MaxRink/km271-wifi/docs/pr-images/jlcpcb-ready/ETH_W5500_pcb_back_after.png

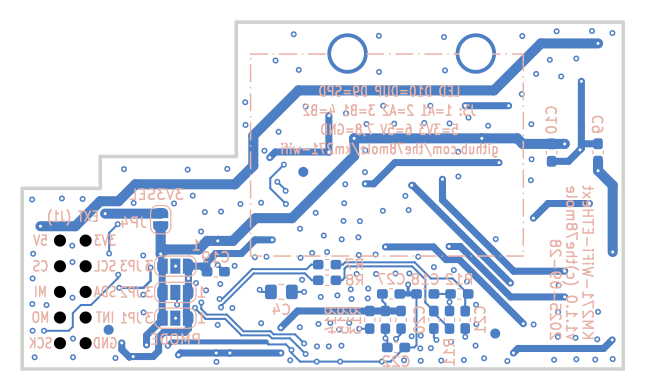
docs/pr-images/jlcpcb-ready/ETH_W5500_pcb_back_after.png
