MaxRink/km271-wifi/docs/pr-images/jlcpcb-ready/ETH_W5500_pcb_back_crop2.png

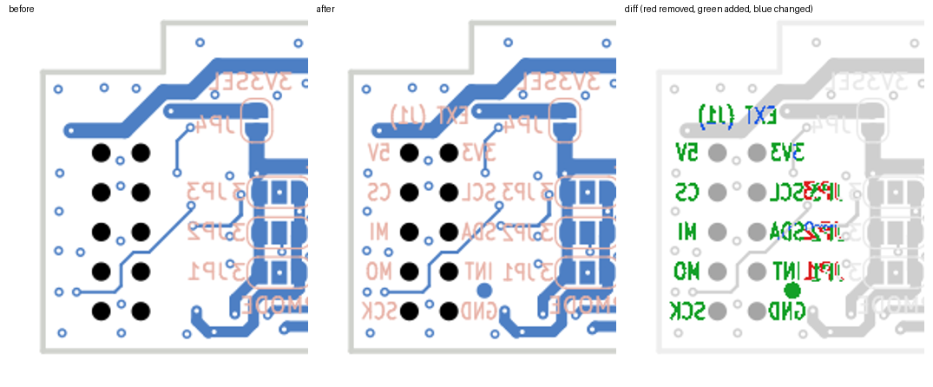
docs/pr-images/jlcpcb-ready/ETH_W5500_pcb_back_crop2.png
