MaxRink/km271-wifi/docs/pr-images/jlcpcb-ready/ETH_W5500_pcb_front_crop1.png

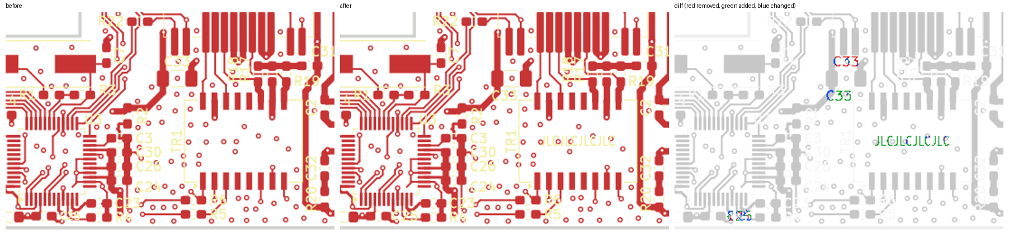
docs/pr-images/jlcpcb-ready/ETH_W5500_pcb_front_crop1.png
