MaxRink/km271-wifi/docs/pr-images/jlcpcb-ready/ETH_W5500_render_iso_after.png

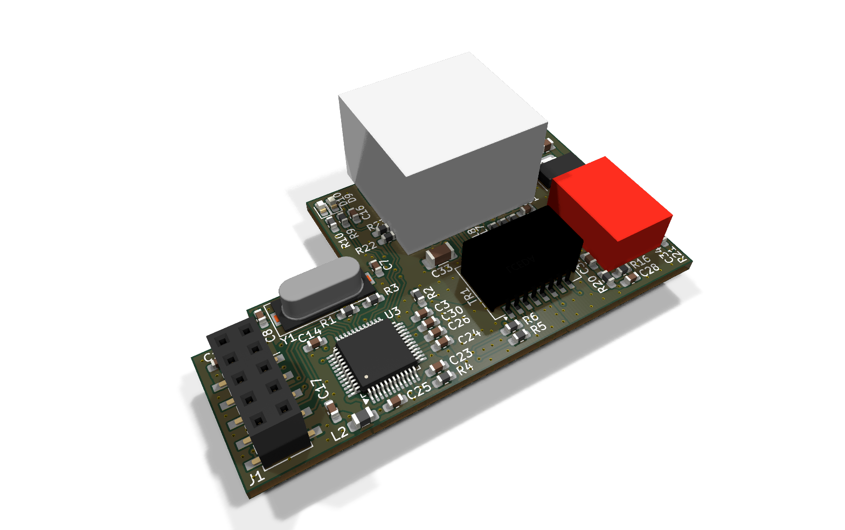
docs/pr-images/jlcpcb-ready/ETH_W5500_render_iso_after.png
