MaxRink/km271-wifi/docs/pr-images/jlcpcb-ready/ETH_W5500_render_top_before.png

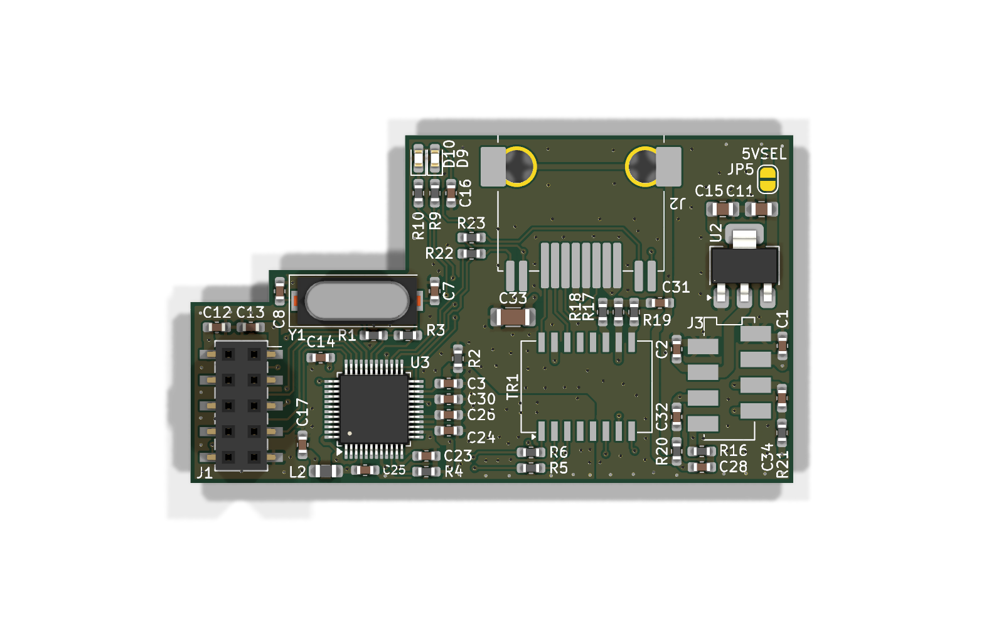
docs/pr-images/jlcpcb-ready/ETH_W5500_render_top_before.png
