MaxRink/km271-wifi/docs/pr-images/jlcpcb-ready/ETH_W5500_sch_crop7.png

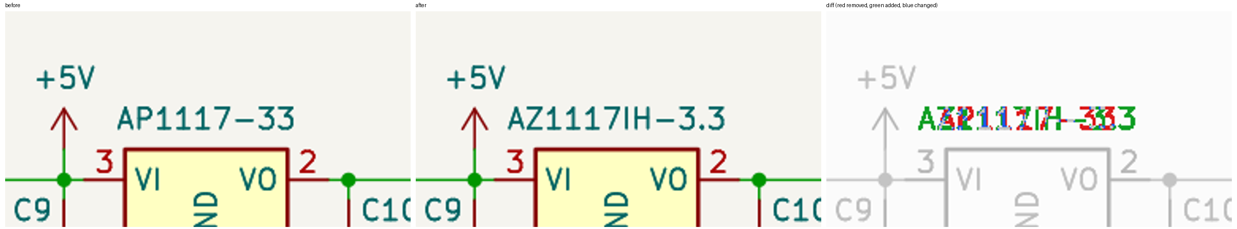
docs/pr-images/jlcpcb-ready/ETH_W5500_sch_crop7.png
