MaxRink/km271-wifi/docs/pr-images/jlcpcb-ready/ETH_W5500_sch_diff.png

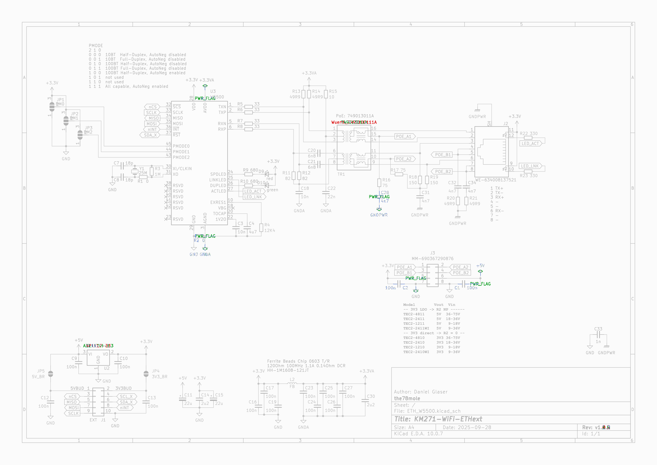
docs/pr-images/jlcpcb-ready/ETH_W5500_sch_diff.png
