MaxRink/km271-wifi/docs/pr-images/jlcpcb-ready/KM217-WiFi_pcb_back_after.png

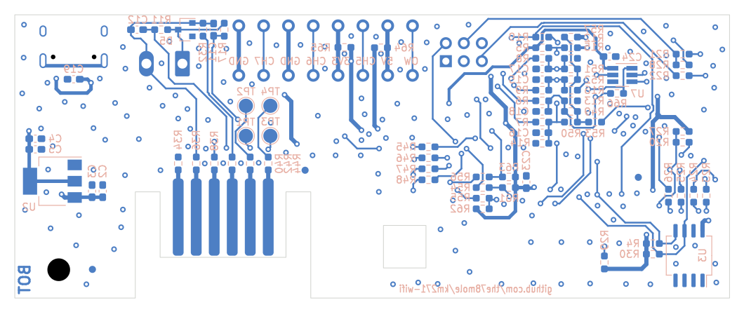
docs/pr-images/jlcpcb-ready/KM217-WiFi_pcb_back_after.png
