MaxRink/km271-wifi/docs/pr-images/jlcpcb-ready/KM217-WiFi_pcb_back_crop1.png

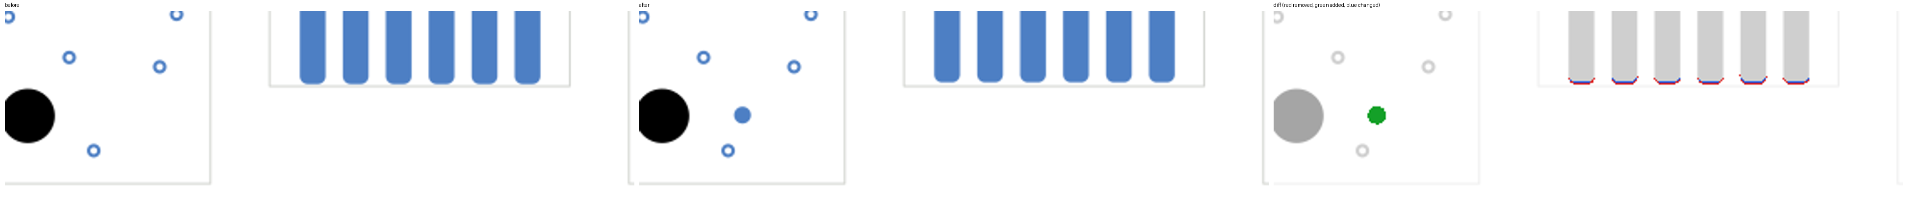
docs/pr-images/jlcpcb-ready/KM217-WiFi_pcb_back_crop1.png
