MaxRink/km271-wifi/docs/pr-images/jlcpcb-ready/KM217-WiFi_pcb_front_before.png

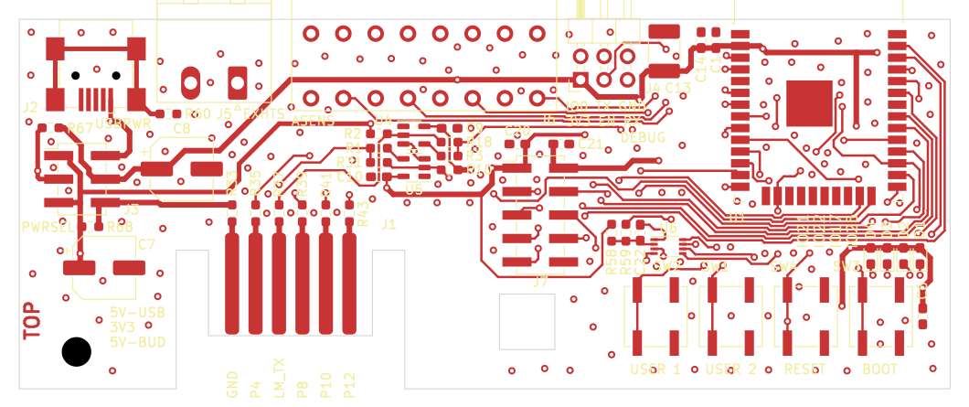
docs/pr-images/jlcpcb-ready/KM217-WiFi_pcb_front_before.png
