MaxRink/km271-wifi/docs/pr-images/jlcpcb-ready/KM217-WiFi_render_bottom_before.png

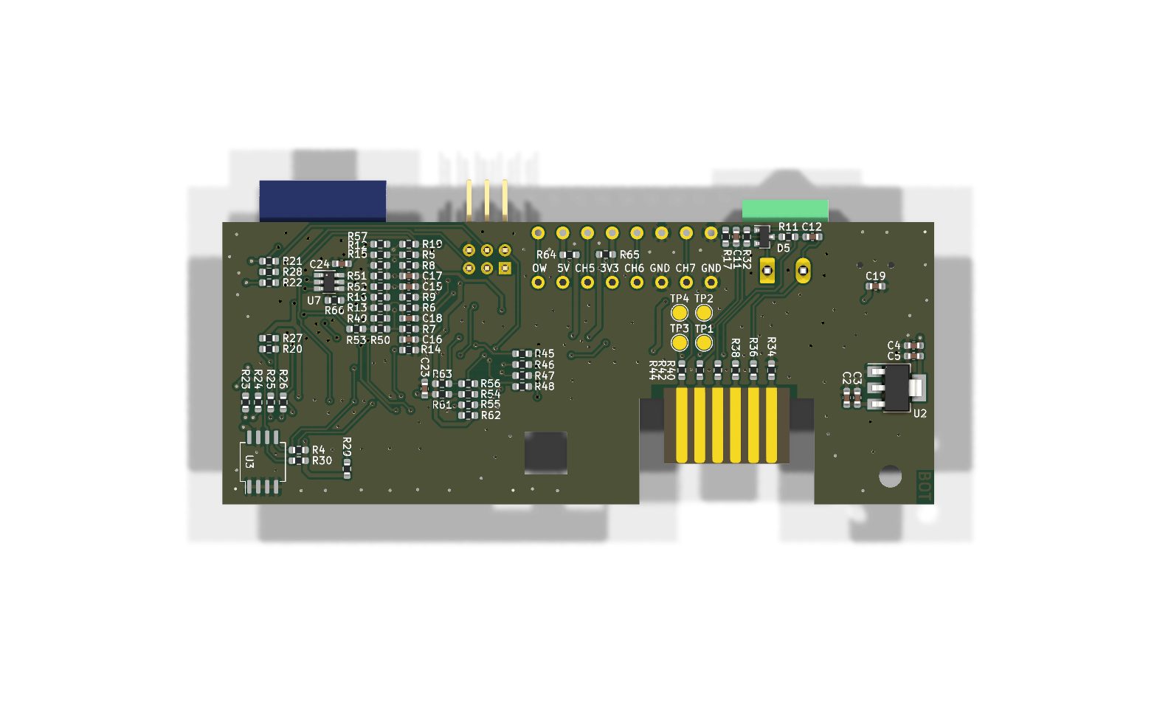
docs/pr-images/jlcpcb-ready/KM217-WiFi_render_bottom_before.png
