MaxRink/km271-wifi/docs/pr-images/jlcpcb-ready/KM217-WiFi_render_top_after.png

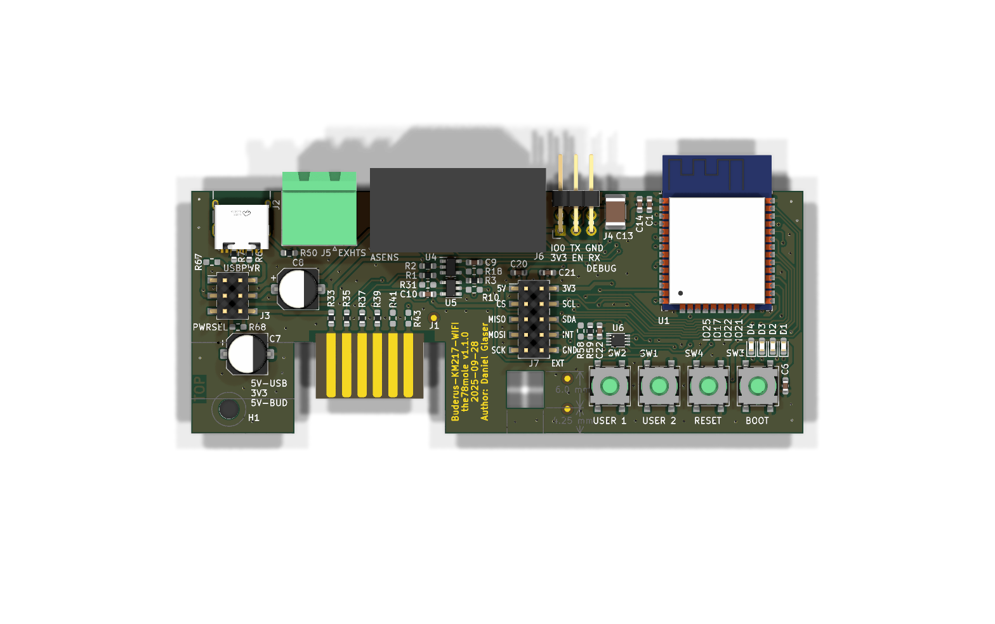
docs/pr-images/jlcpcb-ready/KM217-WiFi_render_top_after.png
