MaxRink/km271-wifi/docs/pr-images/jlcpcb-ready/KM217-WiFi_sch_crop2.png

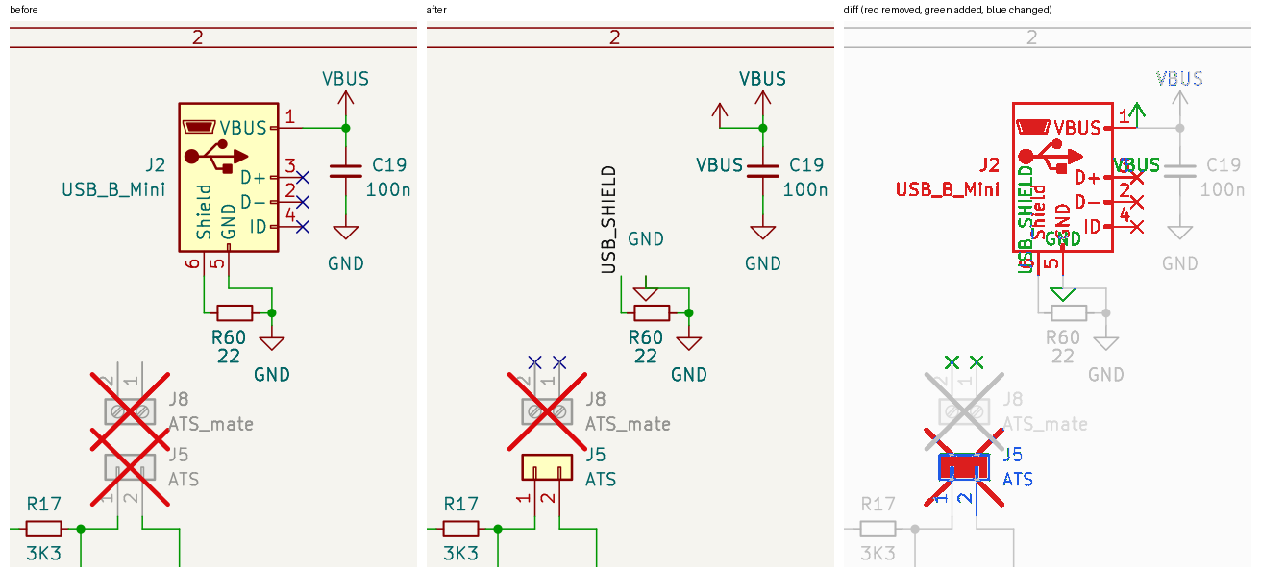
docs/pr-images/jlcpcb-ready/KM217-WiFi_sch_crop2.png
