MaxRink/km271-wifi/IMG/jlc/KM217-WiFi_v1.0.2_top.png

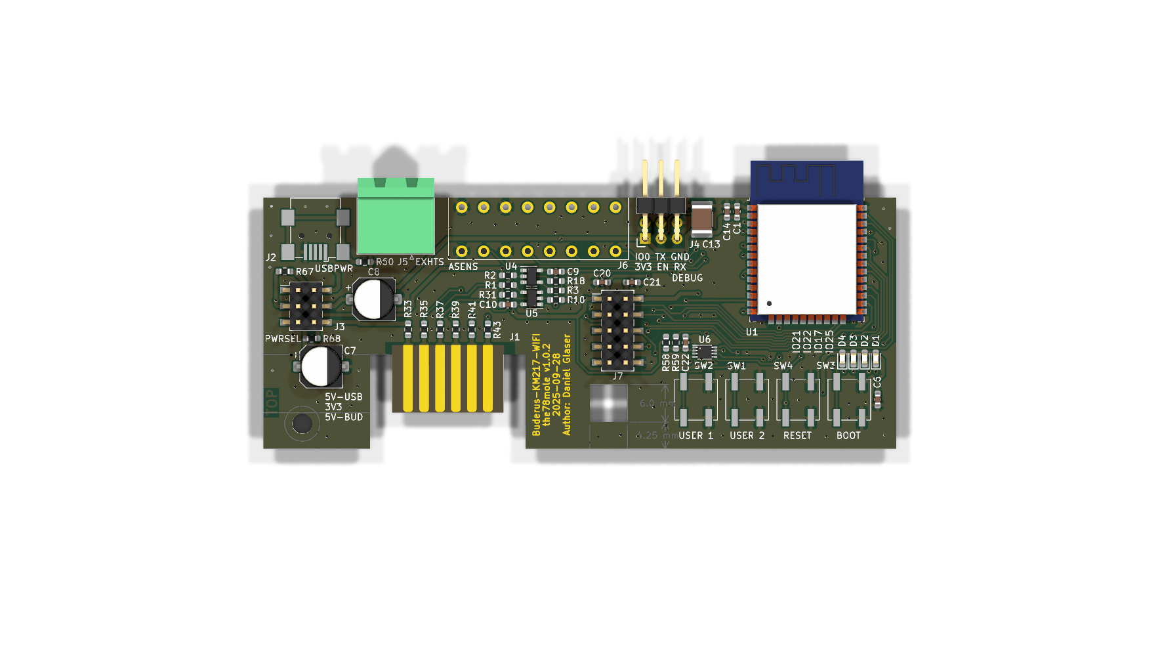
IMG/jlc/KM217-WiFi_v1.0.2_top.png
