MaxRink/km271-wifi/KM217-WiFi/production/bom.csv

Designator | Footprint | Quantity | Value | LCSC Part #
C1, C10, C11, C15, C16, C17, C19, C20, C21, C22, C23, C24, C3, C4, C6, C9 | 0603 | 16 | 100n | C14663
C12 | 0603 | 1 | 33n | C21117
C13 | 1812 | 1 | 22u/25V | C76690
C14, C2, C5 | 0603 | 3 | 2u2 | C23630
C18 | 0603 | 1 | 4p7 | C1669
C7, C8 | CP_Elec_6.3x5.4_Nichicon | 2 | 100u/16V | C340722
D1, D2 | 0603 | 2 | LED green | C12624
D3 | 0603 | 1 | LED yellow | C2287
D4 | 0603 | 1 | LED red | C2286
J2 | USB_C_Receptacle_HRO_TYPE-C-31-M-12 | 1 | USB_C | C165948
J3 | PinHeader_2x03_P2.54mm_Vertical_SMD | 1 | VSEL | C32713283
J4 | PinHeader_2x03_P2.54mm_Horizontal | 1 | DEBUG | C41417351
J5 | PhoenixContact_MSTBA_2,5_2-G-5,08_1x02_P5.08mm_Horizontal | 1 | ATS | C90074
J6 | WAGO 2086-1208 | 1 | TSENS | C6074290
J7 | PinHeader_2x05_P2.54mm_Vertical_SMD | 1 | EXT | C3330868
R1, R19, R20, R21, R22, R3 | 0603 | 6 | 220 | C22962
R11, R5 | 0603 | 2 | 100K | C25803
R12 | 0603 | 1 | 47K | C25819
R16, R49, R50, R51 | 0603 | 4 | 1K | C21190
R17 | 0603 | 1 | 3K3 | C22978
R2, R27, R29, R32 | 0603 | 4 | 10K | C25804
R23, R24, R25, R26 | 0603 | 4 | 680 | C23228
R28 | 0603 | 1 | 1M | C22935
R30, R4, R61, R62, R63 | 0603 | 5 | 4K7 | C23162
R33, R34, R35, R36, R37, R38, R39, R40, R57, R59, R64, R65, R66, R7, R8 | 0603 | 15 | 0 | C21189
R45, R46, R47, R48, R54, R55, R56, R60 | 0603 | 8 | 22 | C23345
R6 | 0603 | 1 | 10 | C22859
R69, R70 | 0603 | 2 | 5K1 | C23186
R9 | 0603 | 1 | 330 | C23138
SW1 | SW_SPST_B3SL-1002P | 1 | USER2 | C306880
SW2 | SW_SPST_B3SL-1002P | 1 | USER1 | C306880
SW3 | SW_SPST_B3SL-1002P | 1 | BOOT | C306880
SW4 | SW_SPST_B3SL-1002P | 1 | RESET | C306880
U1 | ESP32-WROOM-32 | 1 | ESP32-WROOM-32E-N8 | C701342
U2 | SOT-223-3_TabPin2 | 1 | AZ1117IH-3.3TRG1 | C108495
U4, U5 | SOT-23-5 | 2 | SN74LV1T34DBV | C100024
U6 | VSSOP-8_2.3x2mm_P0.5mm | 1 | PCA9306DC1 | C5119911
