MaxRink/km271-wifi/EXTENSIONS/ETH_W5500/production/bom.csv

Designator | Footprint | Quantity | Value | LCSC Part #
C1, C10, C12, C13, C16, C17, C19, C2, C23, C24, C25, C26, C27, C9 | 0603 | 14 | 100n | C14663
C11, C15 | 0805 | 2 | 22u | C45783
C14, C30 | 0603 | 2 | 2u2 | C23630
C18, C3 | 0603 | 2 | 10n | C57112
C20, C21 | 0603 | 2 | 6n8 | C1631
C22 | 0603 | 1 | 22n | C21122
C28, C31, C32, C34 | 0603 | 4 | 4n7 | C53987
C33 | 1206 | 1 | 1n | C9196
C4 | 0805 | 1 | 4u7 | C1779
C7, C8 | 0603 | 2 | 18p | C1647
D10 | 0603 | 1 | green | C12624
D9 | 0603 | 1 | red | C2286
J1 | WE_PinSocket_TH_2x05_P2.54mm_Vertical_SMD | 1 | EXT | C843271
J2 | WE-MJ-634008137521 | 1 | WE-634008137521 | C6095310
J3 | WE-MM-690367290876 | 1 | MM-690367290876 | C20476862
L2 | 0805 | 1 | FB | C1015
R1, R2 | 0603 | 2 | 0 | C21189
R10, R9 | 0603 | 2 | 680 | C23228
R11, R12 | 0603 | 2 | 82 | C23255
R13, R14, R20, R21 | 0603 | 4 | 49R9 | C23185
R15 | 0603 | 1 | 10 | C22859
R16, R17 | 0603 | 2 | 75 | C4275
R18, R19 | 0603 | 2 | 150 | C22808
R22, R23 | 0603 | 2 | 330 | C23138
R3 | 0603 | 1 | 1M | C22935
R4 | 0603 | 1 | 12K4 | C177422
R5, R6, R7, R8 | 0603 | 4 | 33 | C23140
TR1 | Transformer_Ethernet_Wuerth_749013011A | 1 | 749013011A | C7193798
U2 | SOT-223-3_TabPin2 | 1 | AZ1117IH-3.3 | C108495
U3 | LQFP-48_7x7mm_P0.5mm | 1 | W5500 | C32843
Y1 | Crystal_SMD_HC49-SD | 1 | 25M | C596824
