MaxRink/km271-wifi/3dmodels/Wuerth_749013011A.step

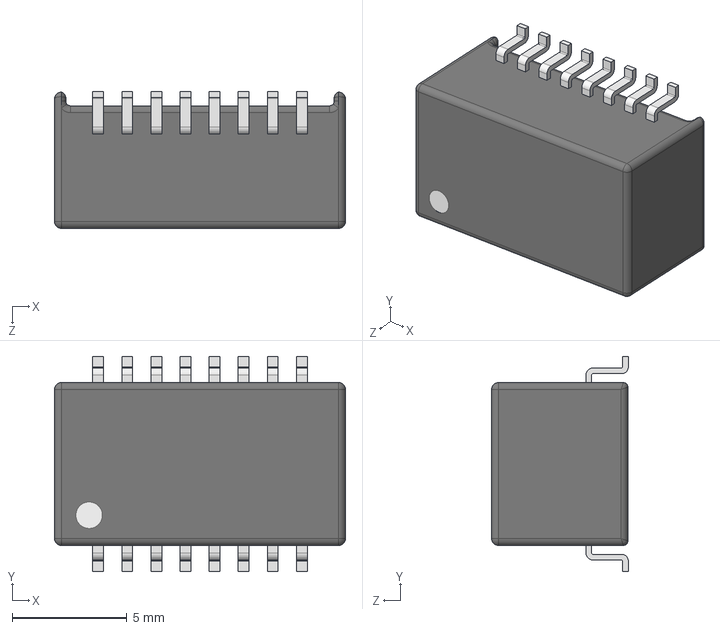
[picture p52: CAD file, 2026-10-25]
3dmodels/Wuerth_749013011A.step
12.7 x 9.40 x 5.97 mm
