MaxRink/km271-wifi/EXTENSIONS/ETH_W5500/production/ETH_W5500.step

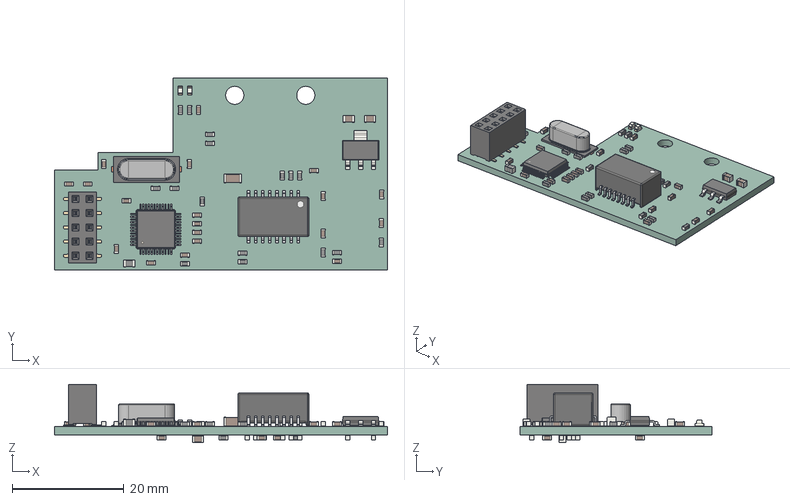
[picture p53: CAD file, 2026-10-25]
EXTENSIONS/ETH_W5500/production/ETH_W5500.step
59.5 x 34.3 x 10.4 mm
C_0603_1608Metric x 27
SOT-223
PinSocket_2x05_P2.54mm_Vertical_SMD
C_1206_3216Metric
L_0603_1608Metric x 23
XFMR-SMD_16P-L12.7-W7.1-P1.27-LS9.4-BL
LED_0603_1608Metric x 2
Crystal_SMD_HC49-SD
L_0805_2012Metric
C_0805_2012Metric x 3
LQFP-48_7x7mm_P0.5mm
.step_tmp_ETH_W5500_PCB
