MaxRink/km271-wifi/KM217-WiFi/production/KM217-WiFi.step

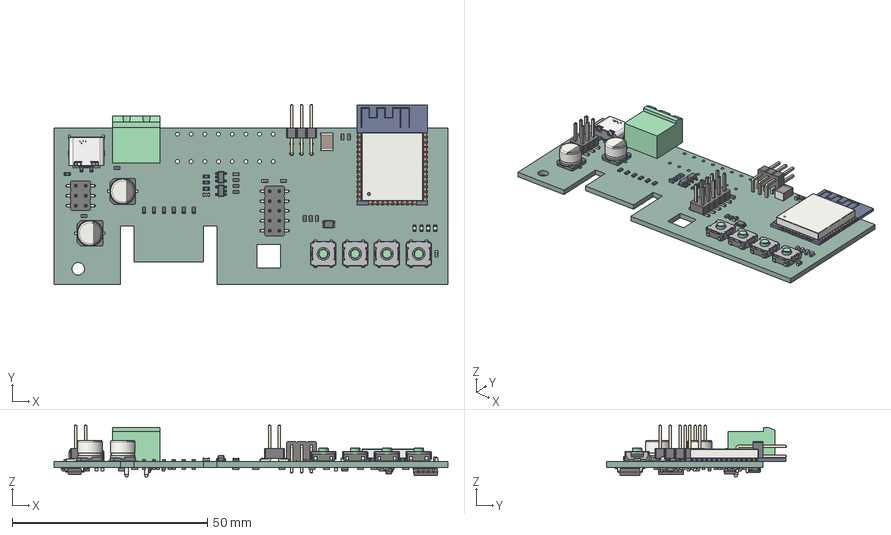
[picture p54: CAD file, 2026-10-25]
KM217-WiFi/production/KM217-WiFi.step
100.8 x 46.0 x 13.3 mm
SW_SPST_B3SL-1002P x 4
R_0603_1608Metric x 70
LED_0603_1608Metric x 4
C_0603_1608Metric x 21
VSSOP-8_2.3x2mm_P0.5mm
SOT-23-5 x 2
PinHeader_2x05_P254mm_Vertical_SMD
CP_Elec_63x54_Nichicon x 2
PinHeader_2x03_P254mm_Horizontal
C_1812_4532Metric
PinHeader_2x03_P254mm_Vertical_SMD
USB-C_SMD-TYPE-C-31-M-12
MSTBA_01x02_G_5_08mm
ESP32-WROOM-32
SOIC-8_5.3x6.2mm_P1.27mm
SOT-23-6
SOT-223
D_SOT_23
.step_tmp_KM217-WiFi_PCB
