MaxRink/km271-wifi/3dmodels/USB-C_HRO_TYPE-C-31-M-12.step

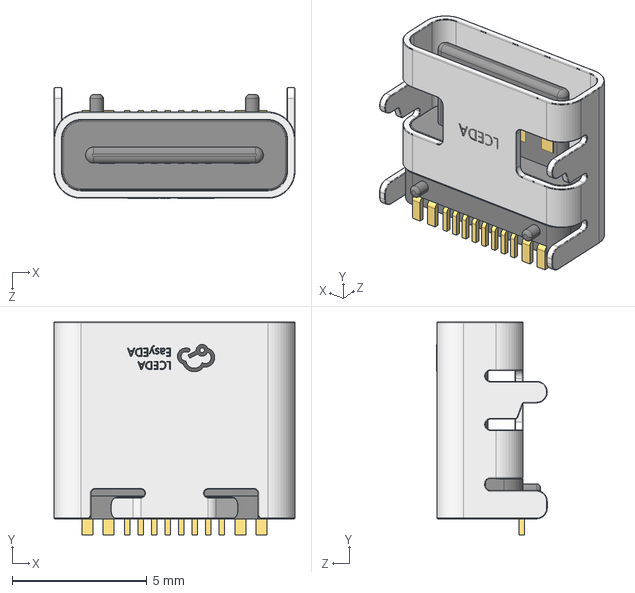
[picture p55: CAD file, 2026-10-25]
3dmodels/USB-C_HRO_TYPE-C-31-M-12.step
8.94 x 7.90 x 4.10 mm
