MaxRink/km271-wifi/KM217-WiFi/production/KM217-WiFi_schematic.pdf

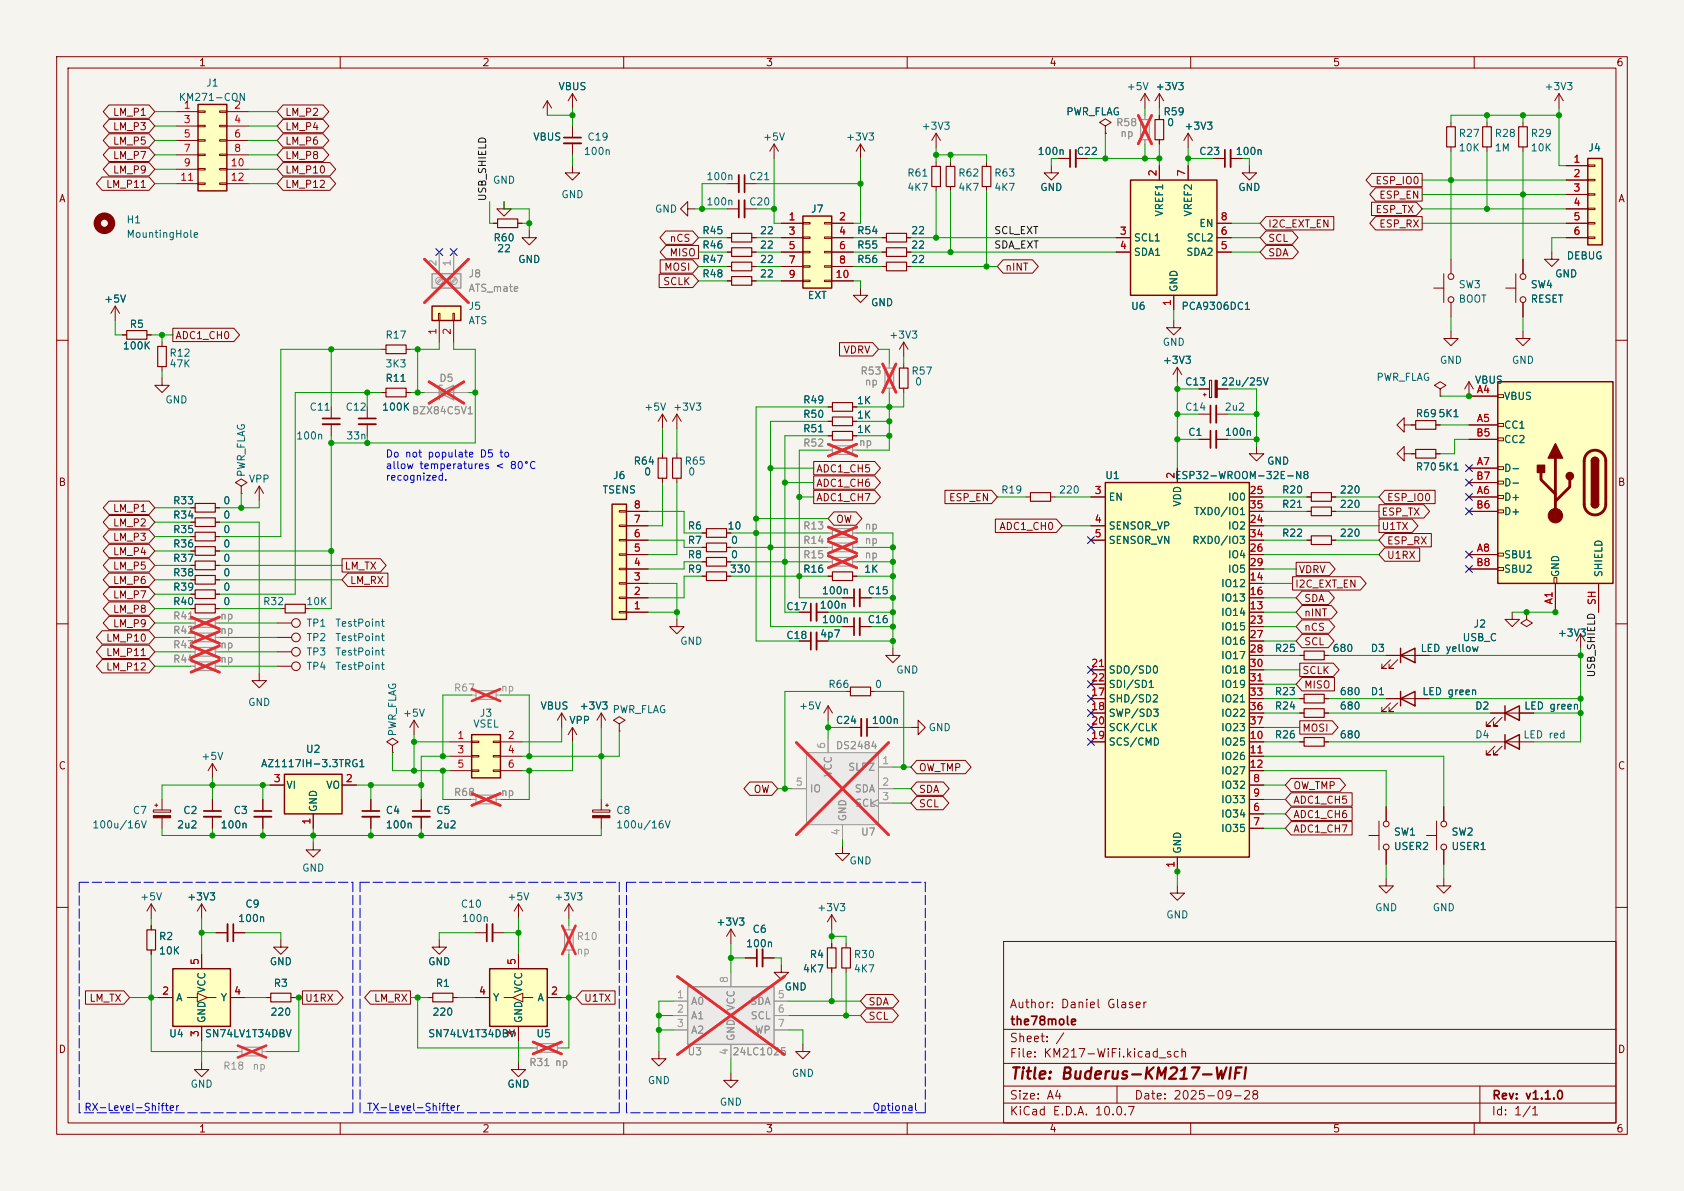
[picture p56: page 1]

4 4
5 5

Do not populate D5 to allow temperatures < 80°C

Size: A4 | Rev: v1.1.0
KiCad E.D.A. 10.0.7 | Id: 1/1
