MaxRink/km271-wifi/EXTENSIONS/ETH_W5500/production/ETH_W5500_schematic.pdf

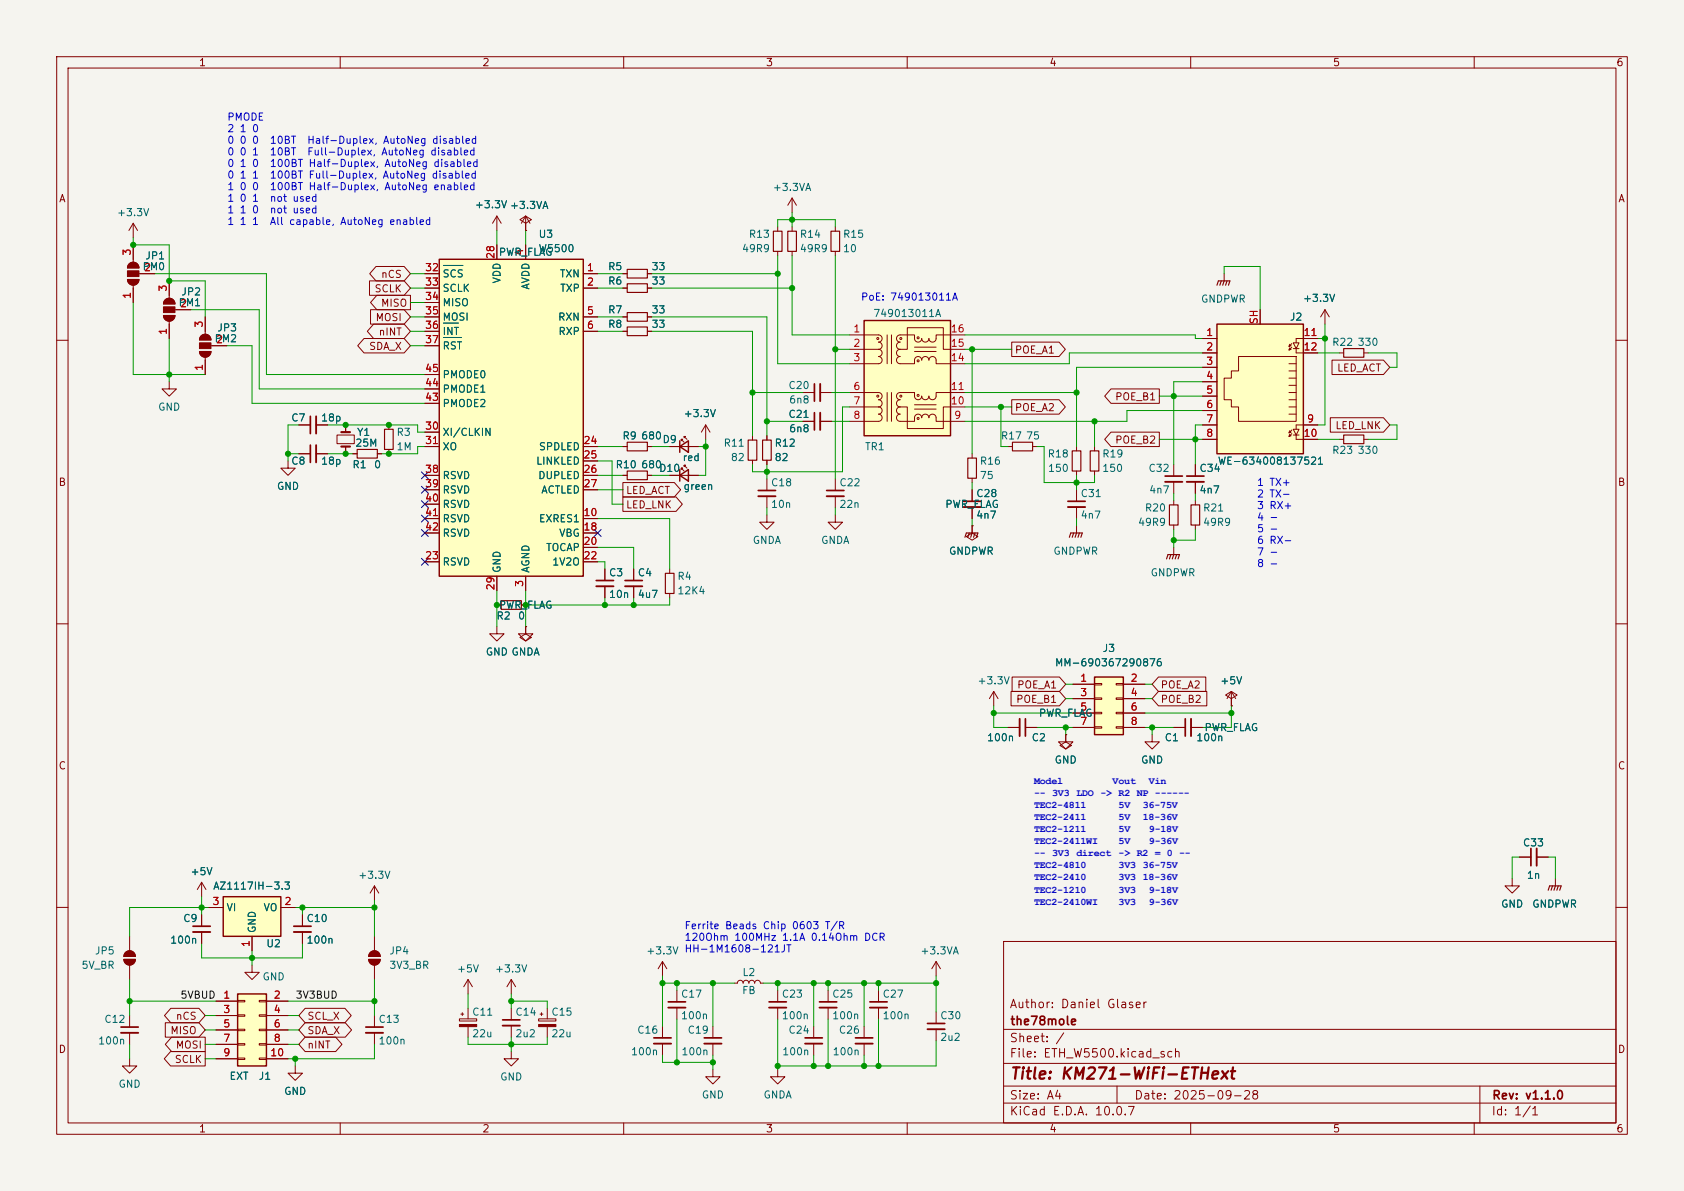
[picture p57: page 1]

PoE: 749013011A PMODE 2 1 0 0 0 0 10BT Half-Duplex, AutoNeg disabled 0 0 1 10BT Full-Duplex, AutoNeg disabled 0 1 0 100BT Half-Duplex, AutoNeg disabled 0 1 1 100BT Full-Duplex, AutoNeg disabled 1 0 0 100BT Half-Duplex, AutoNeg enabled 1 0 1 not used 1 1 0 not used 1 1 1 All capable, AutoNeg enabled

Size: A4 | Rev: v1.1.0
KiCad E.D.A. 10.0.7 | Id: 1/1
