MaxRink/km271-wifi/KM217-WiFi/production/KM217-WiFi_pcb.pdf

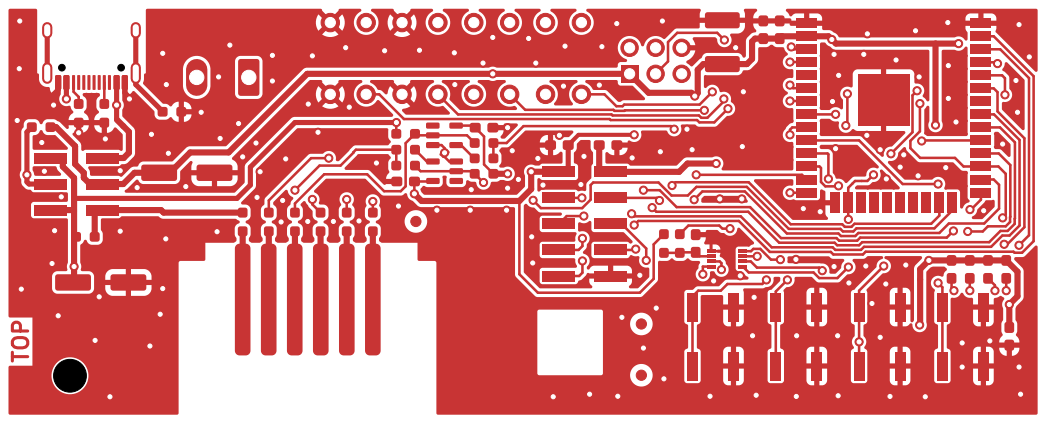
[picture p58: page 1]

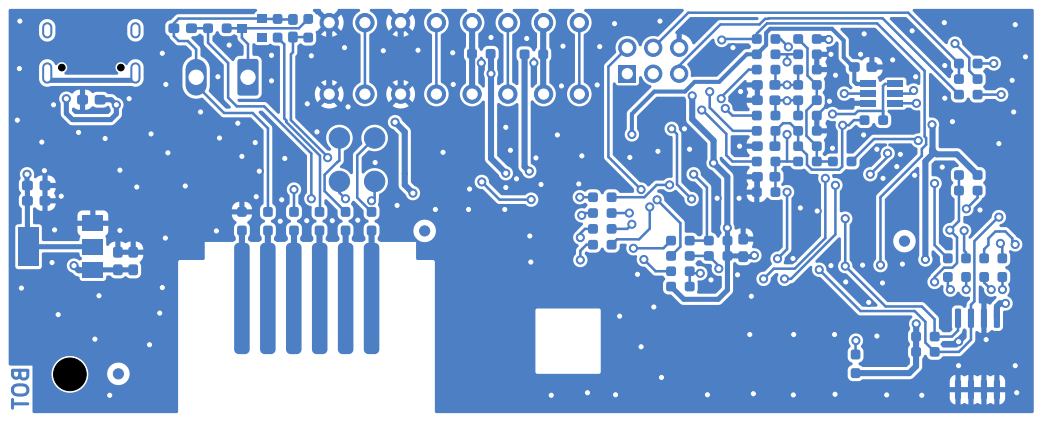
[picture p59: page 2]

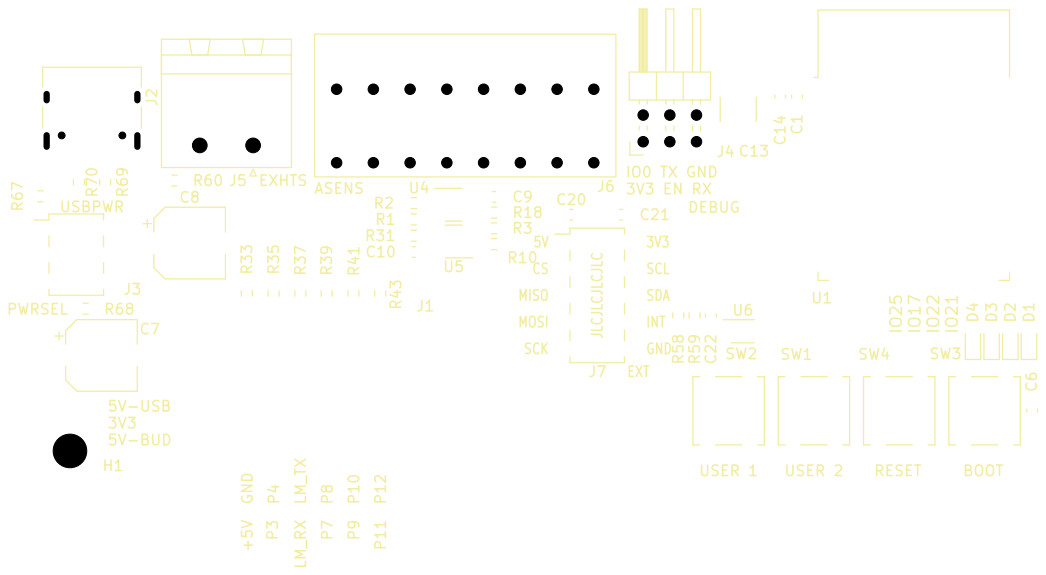
[picture p60: page 3]

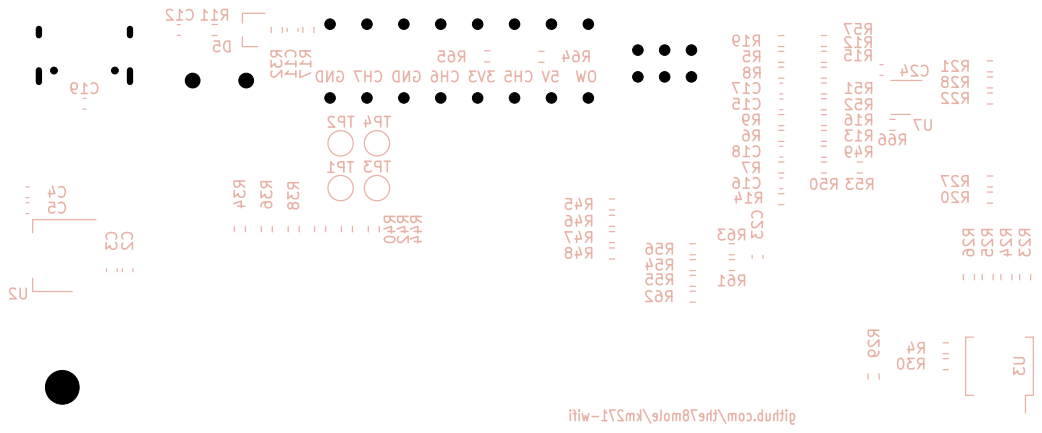
[picture p61: page 4]

github.com/the78mole/km271-wifi GND CH7 GND CH6 3V3 CH5 5V OW C18 C11 R8 R65 R20 C5

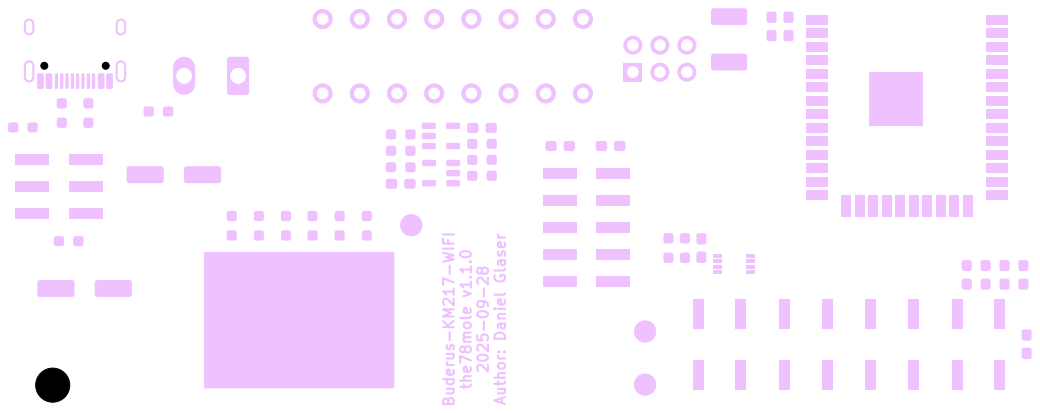
[picture p62: page 5]

Buderus-KM217-WIFI the78mole v1.1.0 2025-09-28 Author: Daniel Glaser

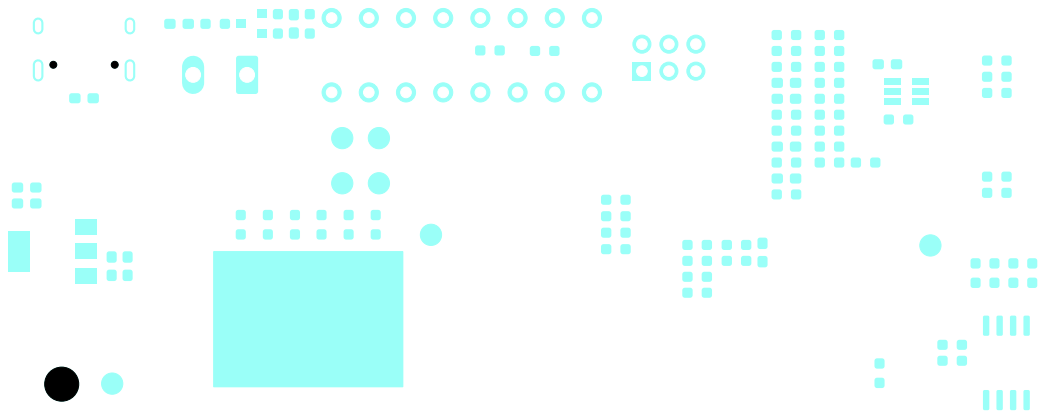
[picture p63: page 6]

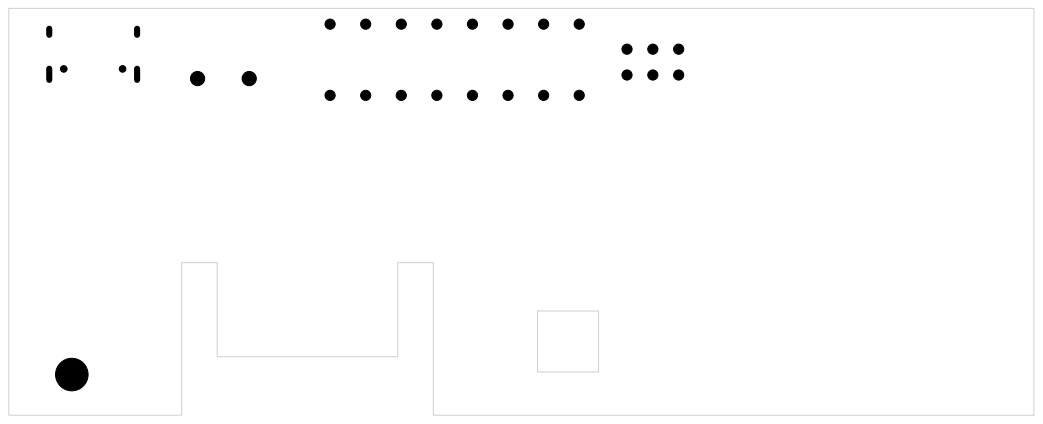
[picture p64: page 7]

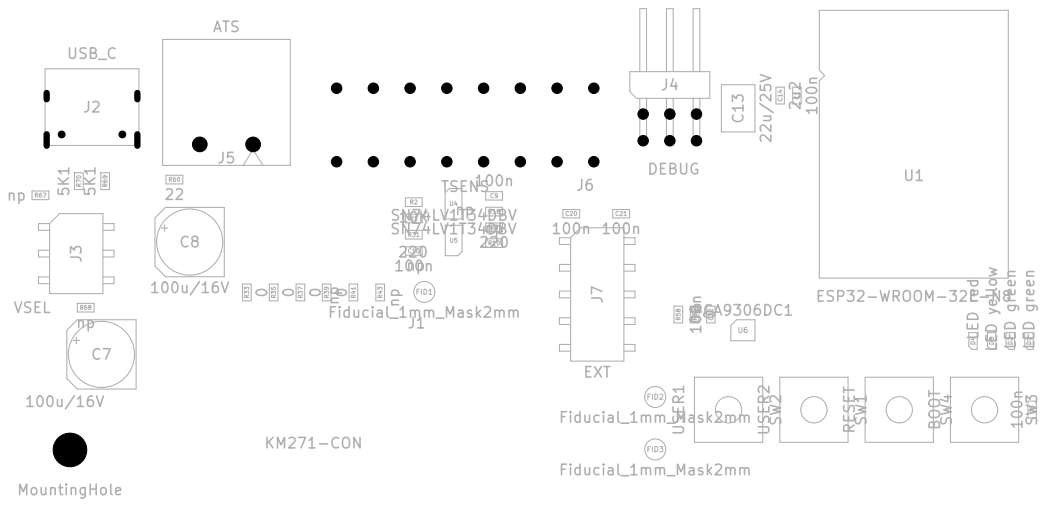
[picture p65: page 8]

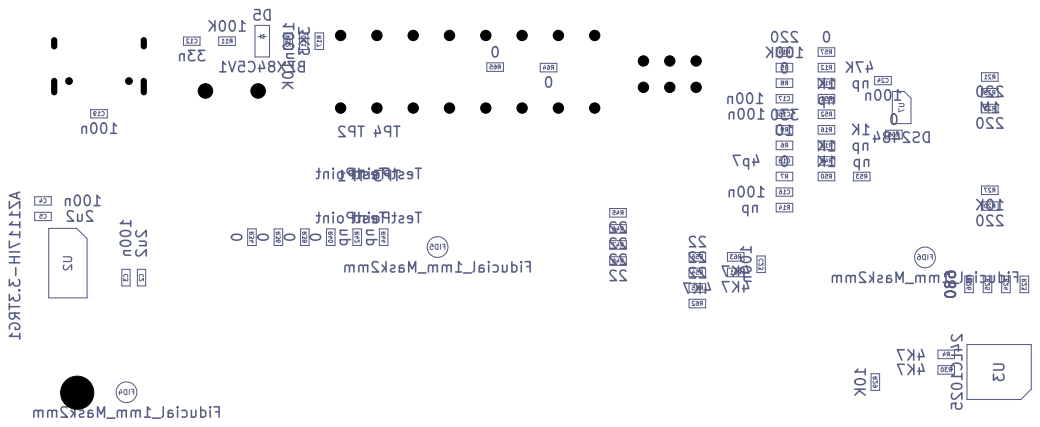
[picture p66: page 9]

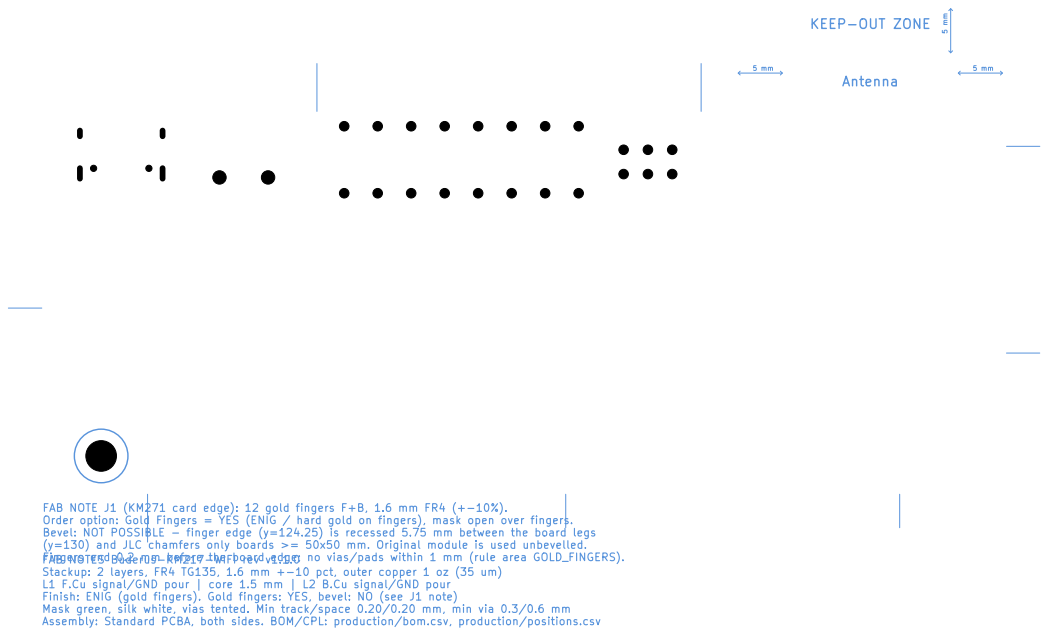
[picture p67: page 10]

(y=130) and JLC chamfers only boards >= 50x50 mm. Original module is used unbevelled. Fingers end 0.2 mm before the board edge; no vias/pads within 1 mm (rule area GOLD_FINGERS).
FAB NOTES Buderus-KM217-WIFI rev v1.1.0
Stackup: 2 layers, FR4 TG135, 1.6 mm +-10 pct, outer copper 1 oz (35 um) L1 F.Cu signal/GND pour | core 1.5 mm | L2 B.Cu signal/GND pour Finish: ENIG (gold fingers). Gold fingers: YES, bevel: NO (see J1 note) Mask green, silk white, vias tented. Min track/space 0.20/0.20 mm, min via 0.3/0.6 mm
