MaxRink/km271-wifi/EXTENSIONS/ETH_W5500/production/ETH_W5500_pcb.pdf

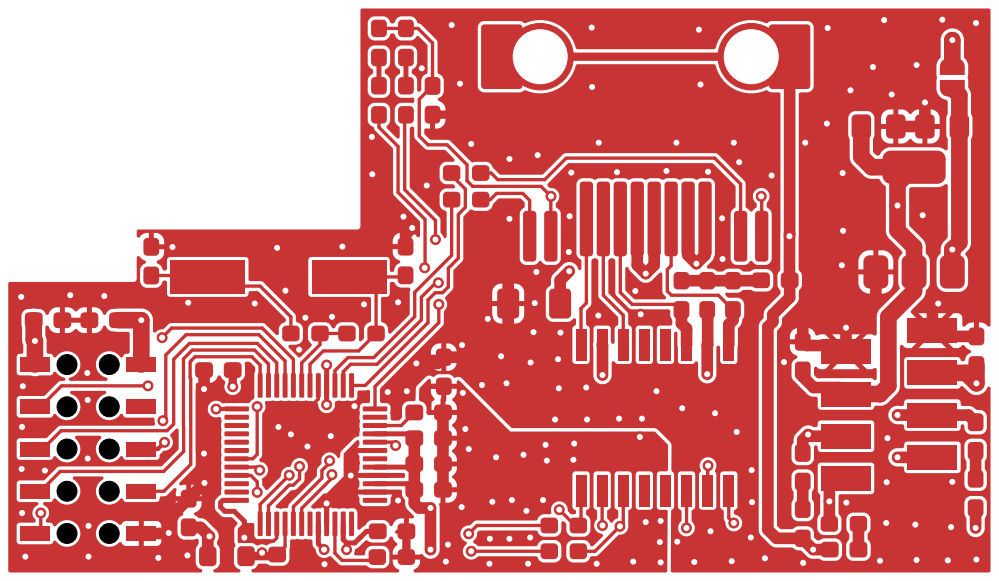
[picture p68: page 1]

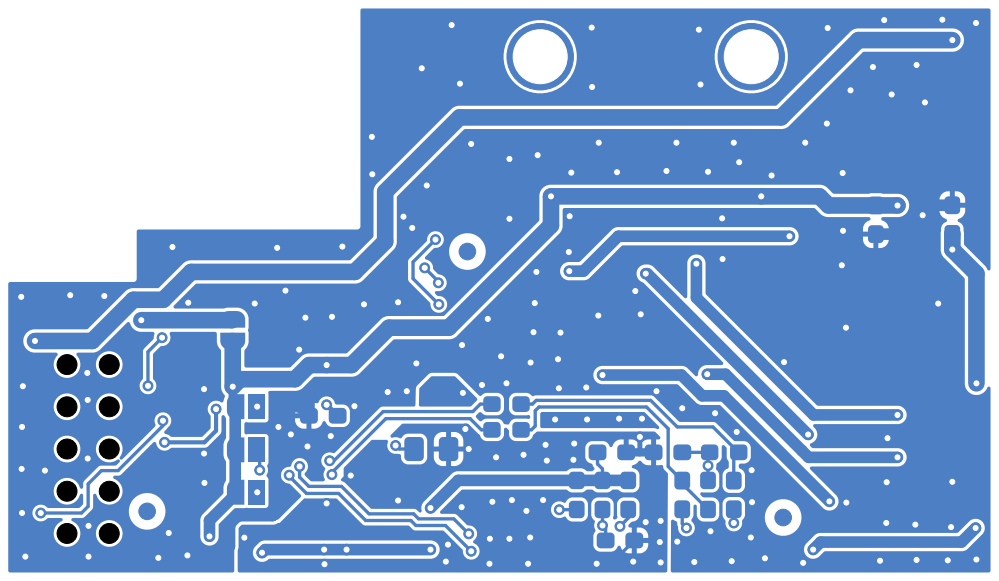
[picture p69: page 2]

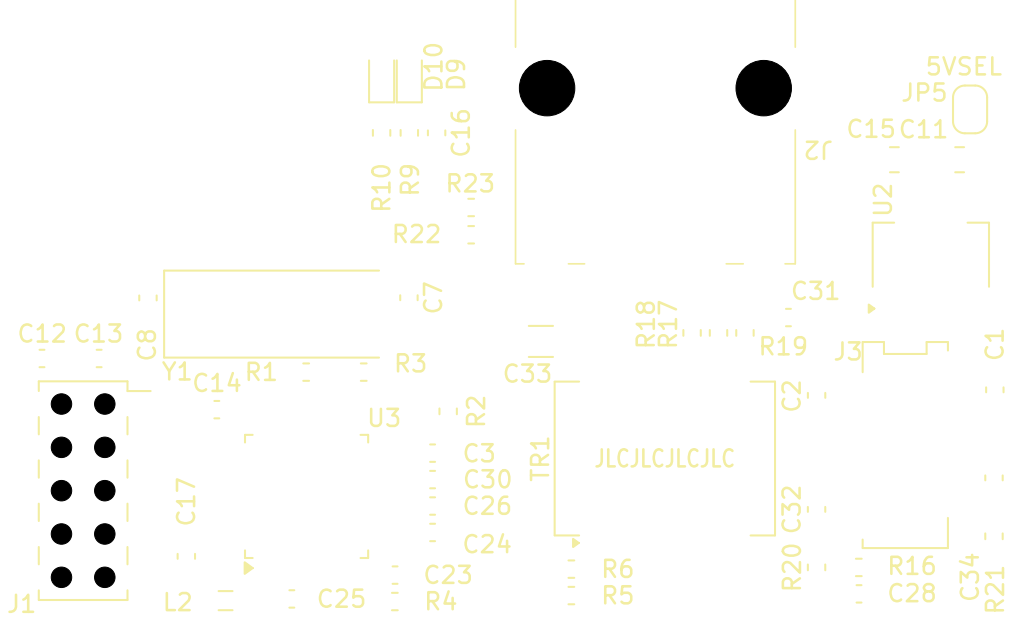
[picture p70: page 3]

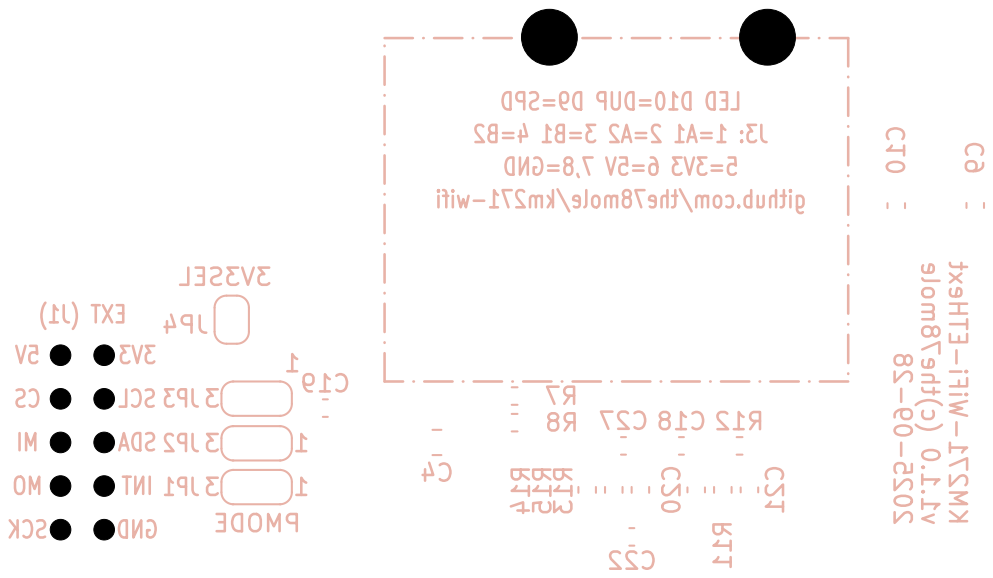
[picture p71: page 4]

D9=SPD D10=DUP LED 4=B2 3=B1 2=A2 1=A1 J3: 7,8=GND 6=5V 5=3V3 github.com/the78mole/km271-wifi 3V3SEL PMODE v1.1.0 KM271-WiFi-ETHext (c)the78mole R11 2025-09-28 C18C22

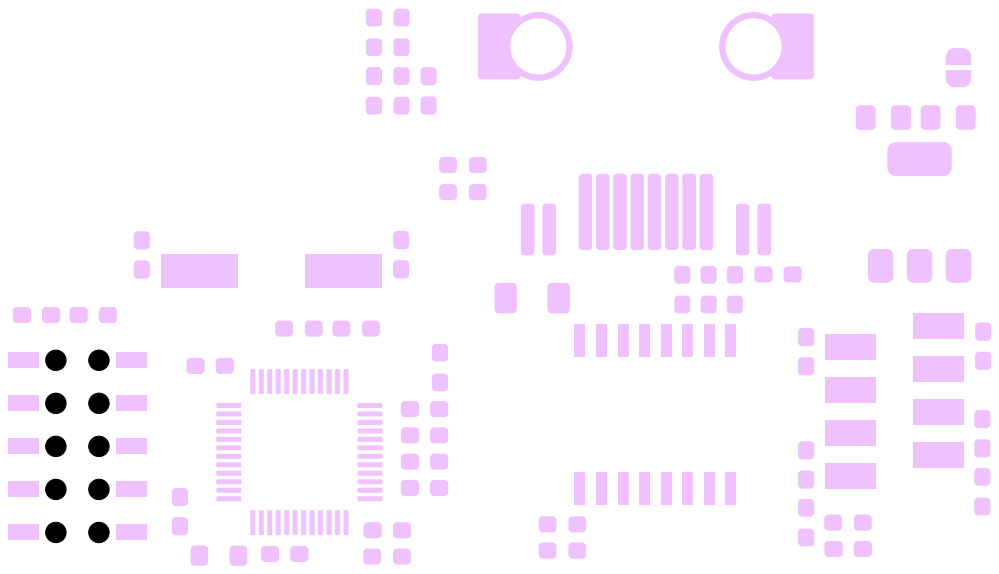
[picture p72: page 5]

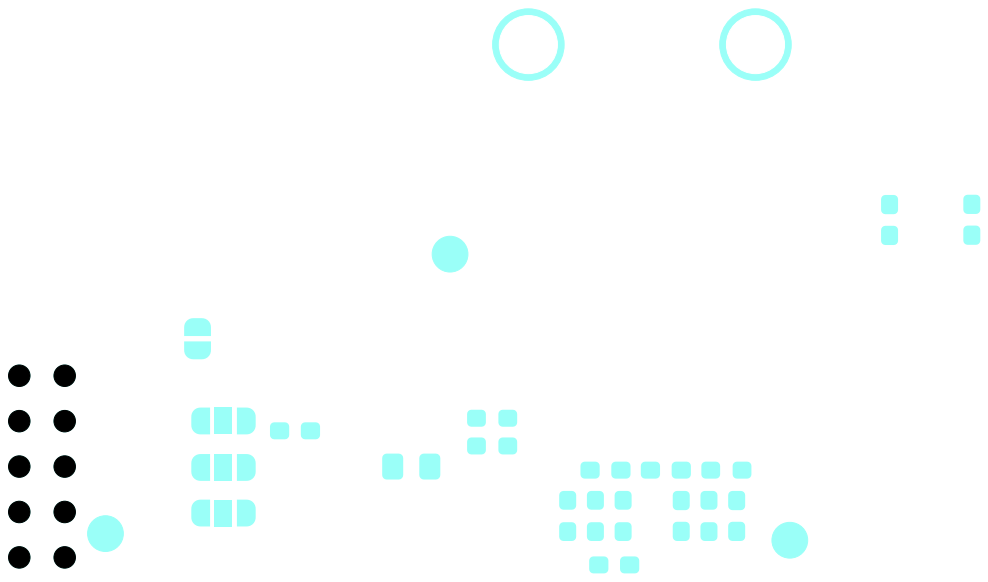
[picture p73: page 6]

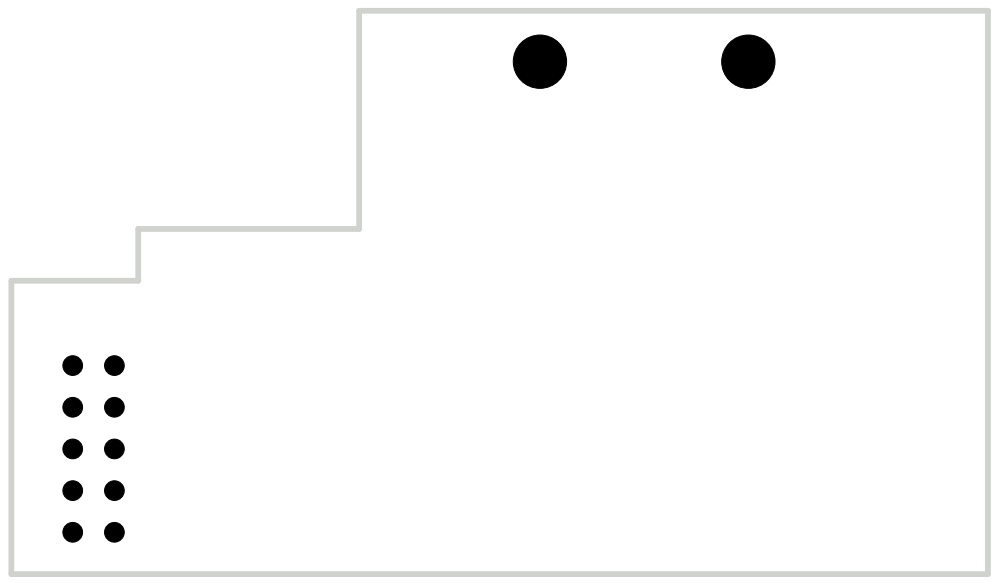
[picture p74: page 7]

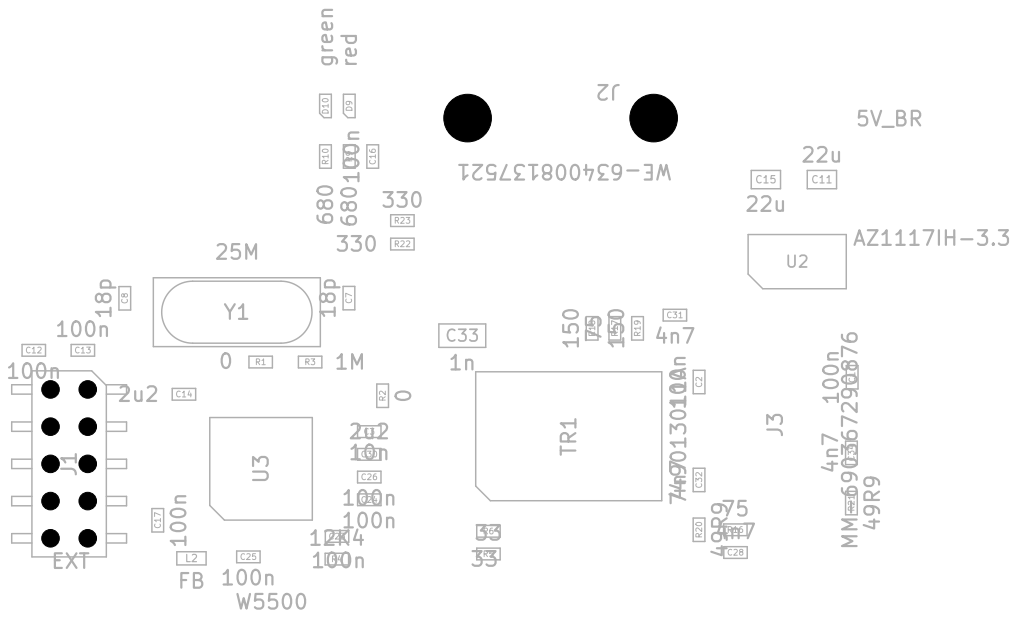
[picture p75: page 8]

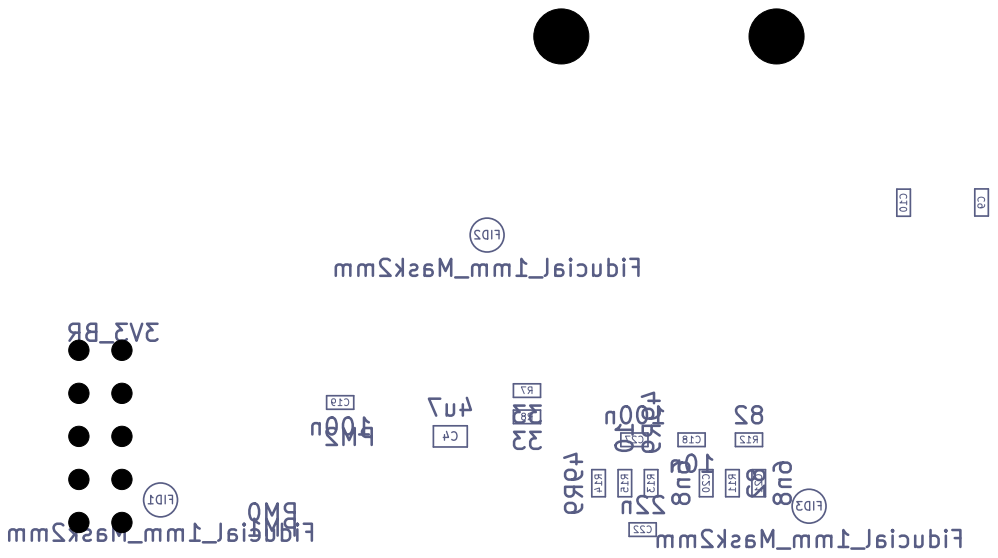
[picture p76: page 9]

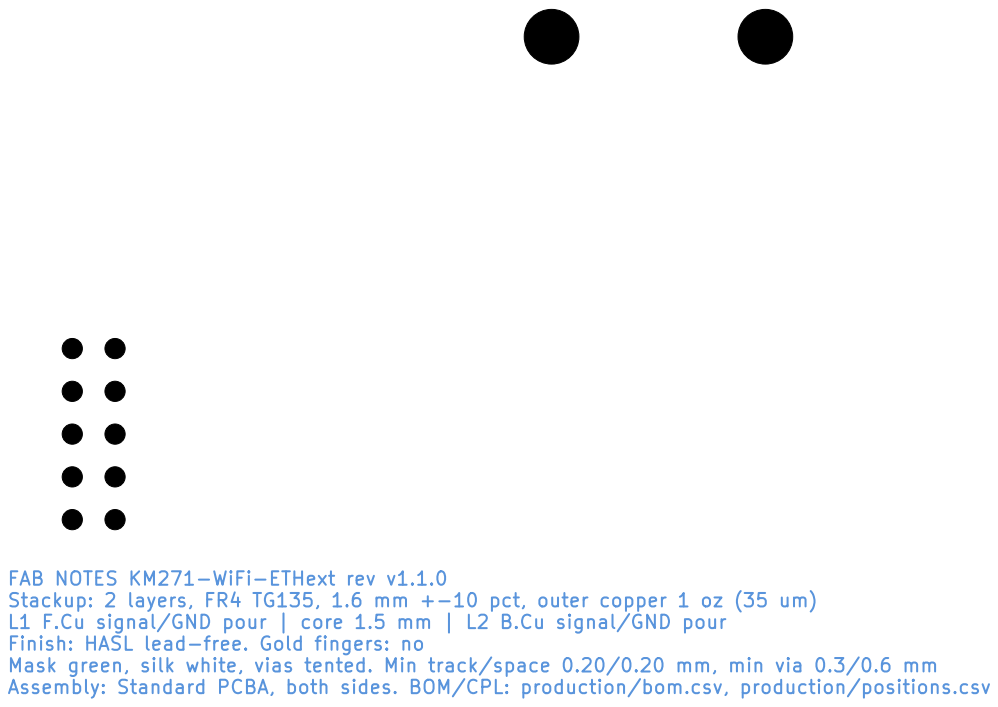
[picture p77: page 10]

FAB NOTES KM271-WiFi-ETHext rev v1.1.0
Stackup: 2 layers, FR4 TG135, 1.6 mm +-10 pct, outer copper 1 oz (35 um) L1 F.Cu signal/GND pour | core 1.5 mm | L2 B.Cu signal/GND pour Finish: HASL lead-free. Gold fingers: no Mask green, silk white, vias tented. Min track/space 0.20/0.20 mm, min via 0.3/0.6 mm

Assembly: Standard PCBA, both sides. BOM/CPL: production/bom.csv, production/positions.csv
