MaxRink/km271-wifi/EXTENSIONS/ETH_W5500/ETH_W5500.kicad_pcb

## KiCad design EXTENSIONS/ETH_W5500/ETH_W5500.kicad_pcb (2026-10-25)

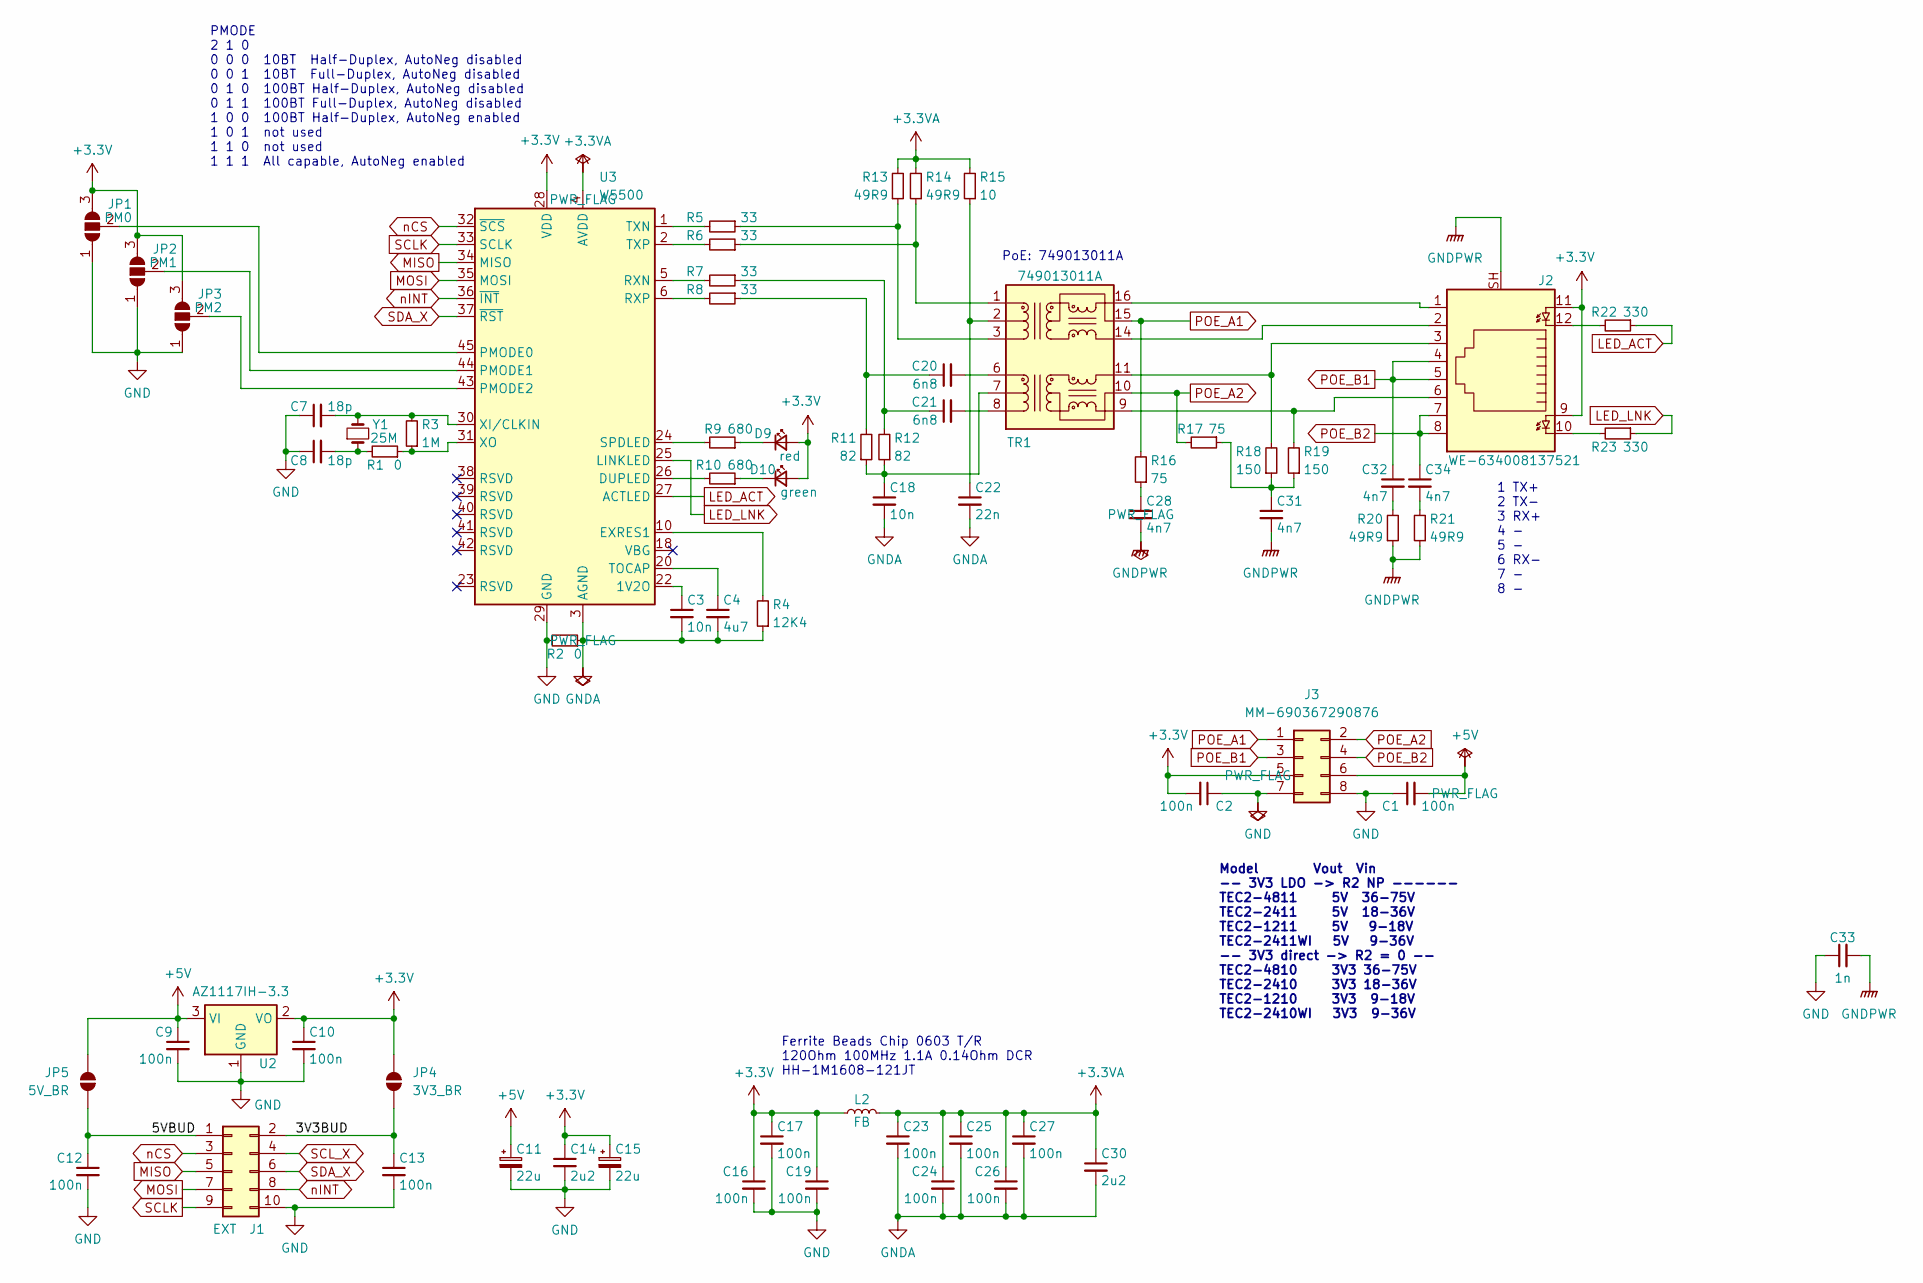
[picture p78: schematic ETH_W5500.kicad_sch, KM271-WiFi-ETHext]

Parts:
C1, C2, C9, C10, C12, C13, C16, C17, C19, C23, C24, C25, C26, C27: 100n; C_0603_1608Metric_Pad1.08x0.95mm_HandSolder; LCSC C14663
C3, C18: 10n; C_0603_1608Metric_Pad1.08x0.95mm_HandSolder; LCSC C57112
C4: 4u7; C_0805_2012Metric_Pad1.18x1.45mm_HandSolder; LCSC C1779
C7, C8: 18p; C_0603_1608Metric_Pad1.08x0.95mm_HandSolder; LCSC C1647
C11, C15: 22u; C_0805_2012Metric_Pad1.18x1.45mm_HandSolder; LCSC C45783
C14, C30: 2u2; C_0603_1608Metric_Pad1.08x0.95mm_HandSolder; LCSC C23630
C20, C21: 6n8; C_0603_1608Metric_Pad1.08x0.95mm_HandSolder; LCSC C1631
C22: 22n; C_0603_1608Metric_Pad1.08x0.95mm_HandSolder; LCSC C21122
C28, C31, C32, C34: 4n7; C_0603_1608Metric_Pad1.08x0.95mm_HandSolder; LCSC C53987
C33: 1n; C_1206_3216Metric_Pad1.33x1.80mm_HandSolder; LCSC C9196
D9: red; LED_0603_1608Metric_Pad1.05x0.95mm_HandSolder; LCSC C2286
D10: green; LED_0603_1608Metric_Pad1.05x0.95mm_HandSolder; LCSC C12624
J1: EXT; WE_PinSocket_TH_2x05_P2.54mm_Vertical_SMD; MPN 2.54-2*5P Female Header SMD; LCSC C843271
J2: WE-634008137521; WE-MJ-634008137521; LCSC C6095310
J3: MM-690367290876; WE-MM-690367290876; LCSC C20476862
JP1: PM0; SolderJumper-3_P1.3mm_Open_RoundedPad1.0x1.5mm_NumberLabels
JP2: PM1; SolderJumper-3_P1.3mm_Open_RoundedPad1.0x1.5mm_NumberLabels
JP3: PM2; SolderJumper-3_P1.3mm_Open_RoundedPad1.0x1.5mm_NumberLabels
JP4: 3V3_BR; SolderJumper-2_P1.3mm_Open_RoundedPad1.0x1.5mm
JP5: 5V_BR; SolderJumper-2_P1.3mm_Open_RoundedPad1.0x1.5mm
L2: FB; L_0805_2012Metric_Pad1.05x1.20mm_HandSolder; LCSC C1015
R1, R2: 0; L_0603_1608Metric_Pad1.05x0.95mm_HandSolder; LCSC C21189
R3: 1M; L_0603_1608Metric_Pad1.05x0.95mm_HandSolder; LCSC C22935
R4: 12K4; L_0603_1608Metric_Pad1.05x0.95mm_HandSolder; LCSC C177422
R5, R6, R7, R8: 33; L_0603_1608Metric_Pad1.05x0.95mm_HandSolder; LCSC C23140
R9, R10: 680; L_0603_1608Metric_Pad1.05x0.95mm_HandSolder; LCSC C23228
R11, R12: 82; L_0603_1608Metric_Pad1.05x0.95mm_HandSolder; LCSC C23255
R13, R14, R20, R21: 49R9; L_0603_1608Metric_Pad1.05x0.95mm_HandSolder; LCSC C23185
R15: 10; L_0603_1608Metric_Pad1.05x0.95mm_HandSolder; LCSC C22859
R16, R17: 75; L_0603_1608Metric_Pad1.05x0.95mm_HandSolder; LCSC C4275
R18, R19: 150; L_0603_1608Metric_Pad1.05x0.95mm_HandSolder; LCSC C22808
R22, R23: 330; L_0603_1608Metric_Pad1.05x0.95mm_HandSolder; LCSC C23138
TR1: 749013011A; Transformer_Ethernet_Wuerth_749013011A; LCSC C7193798
U2: AZ1117IH-3.3; SOT-223-3_TabPin2; MPN AZ1117IH-3.3TRG1; LCSC C108495
U3: W5500; LQFP-48_7x7mm_P0.5mm; LCSC C32843
Y1: 25M; Crystal_SMD_HC49-SD; MPN ABLS2-25.000MHZ-D4YF-T; LCSC C596824

Connections:
+3.3V: C2.2, C10.1, C14.1, C15.1, C16.1, C17.1, C19.1, D9.2 (A), D10.2 (A), J2.9, J2.11, J3.5, JP1.3 (B), JP2.3 (B), JP3.3 (B), JP4.1 (A), L2.1, U2.2 (VO), U3.28 (VDD)
+3.3VA: C23.1, C24.1, C25.1, C26.1, C27.1, C30.1, L2.2, R13.2, R14.2, R15.2, U3.4 (AVDD), U3.8 (AVDD), U3.11 (AVDD), U3.15 (AVDD), U3.17 (AVDD), U3.21 (AVDD)
+5V: C1.2, C9.1, C11.1, J3.6, JP5.1 (A), U2.3 (VI)
/3V3BUD: C13.1, J1.2, JP4.2 (B)
/5VBUD: C12.1, J1.1, JP5.2 (B)
GND: C1.1, C2.1, C7.1, C8.1, C9.2, C10.2, C11.2, C12.2, C13.2, C14.2, C15.2, C16.2, C17.2, C19.2, C33.1, J1.10, J3.7, J3.8, JP1.1 (A), JP2.1 (A), JP3.1 (A), R2.2, U2.1 (GND), U3.29 (GND)
GNDA: C3.2, C4.2, C18.2, C22.2, C23.2, C24.2, C25.2, C26.2, C27.2, C30.2, R2.1, R4.1, U3.3 (AGND), U3.9 (AGND), U3.14 (AGND), U3.16 (AGND), U3.19 (AGND), U3.48 (AGND)
GNDPWR: C28.2, C31.2, C33.2, J2.SH, R20.1, R21.1
LED_ACT: R22.1, U3.27 (ACTLED)
LED_LNK: R23.1, U3.25 (LINKLED)
MISO: J1.5, U3.34 (MISO)
MOSI: J1.7, U3.35 (MOSI)
unnamed: C8.2, R1.2, Y1.1
unnamed: C20.1, R8.1, R11.2
unnamed: C21.1, R7.1, R12.2
unnamed: C28.1, R16.1
unnamed: C31.1, R17.1, R18.1, R19.1
unnamed: C32.2, R20.2
unnamed: C34.2, R21.2
unnamed: D9.1 (K), R9.1
unnamed: D10.1 (K), R10.1
unnamed: J2.10, R23.2
unnamed: J2.12, R22.2
unnamed: JP1.2 (C), U3.45 (PMODE0)
unnamed: JP2.2 (C), U3.44 (PMODE1)
unnamed: JP3.2 (C), U3.43 (PMODE2)
unnamed: C18.1, R11.1, R12.1, TR1.7 (C_RD)
unnamed: C22.1, R15.1, TR1.2 (C_TD)
unnamed: C20.2, TR1.6 (RD+)
unnamed: C21.2, TR1.8 (RD-)
unnamed: J2.3, R18.2, TR1.11 (RX+)
unnamed: J2.6, R19.2, TR1.9 (RX-)
unnamed: R6.1, R14.1, TR1.1 (TD+)
unnamed: R5.1, R13.1, TR1.3 (TD-)
unnamed: J2.1, TR1.16 (TX+)
unnamed: J2.2, TR1.14 (TX-)
unnamed: C3.1, U3.22 (1V2O)
unnamed: R10.2, U3.26 (DUPLED)
unnamed: R4.2, U3.10 (EXRES1)
unnamed: R7.2, U3.5 (RXN)
unnamed: R8.2, U3.6 (RXP)
unnamed: R9.2, U3.24 (SPDLED)
unnamed: C4.1, U3.20 (TOCAP)
unnamed: R5.2, U3.1 (TXN)
unnamed: R6.2, U3.2 (TXP)
unnamed: C7.2, R3.2, U3.30 (XI/CLKIN), Y1.2
unnamed: R1.1, R3.1, U3.31 (XO)
POE_A1: J3.1, R16.2, TR1.15 (C_TX)
POE_A2: J3.2, R17.2, TR1.10 (C_RX)
POE_B1: C32.1, J2.4, J2.5, J3.3
POE_B2: C34.1, J2.7, J2.8, J3.4
SCLK: J1.9, U3.33 (SCLK)
SCL_X: J1.4
SDA_X: J1.6, U3.37 (~RST)
nCS: J1.3, U3.32 (~SCS)
nINT: J1.8, U3.36 (~INT)

Notes on the sheet:
PMODE 2 1 0 0 0 0 10BT Half-Duplex, AutoNeg disabled 0 0 1 10BT Full-Duplex, AutoNeg disabled 0 1 0 100BT Half-Duplex, AutoNeg disabled 0 1 1 100BT Full-Duplex, AutoNeg disabled 1 0 0 100BT Half-Duplex, AutoNeg enabled 1 0 1 not used 1 1 0 not used 1 1 1 All capable, AutoNeg enabled
PoE: 749013011A
Ferrite Beads Chip 0603 T/R 120Ohm 100MHz 1.1A 0.14Ohm DCR HH-1M1608-121JT
Model Vout Vin -- 3V3 LDO -> R2 NP ------ TEC2-4811 5V 36-75V TEC2-2411 5V 18-36V TEC2-1211 5V 9-18V TEC2-2411WI 5V 9-36V -- 3V3 direct -> R2 = 0 -- TEC2-4810 3V3 36-75V TEC2-2410 3V3 18-36V TEC2-1210 3V3 9-18V TEC2-2410WI 3V3 9-36V
1 TX+ 2 TX- 3 RX+ 4 - 5 - 6 RX- 7 - 8 -

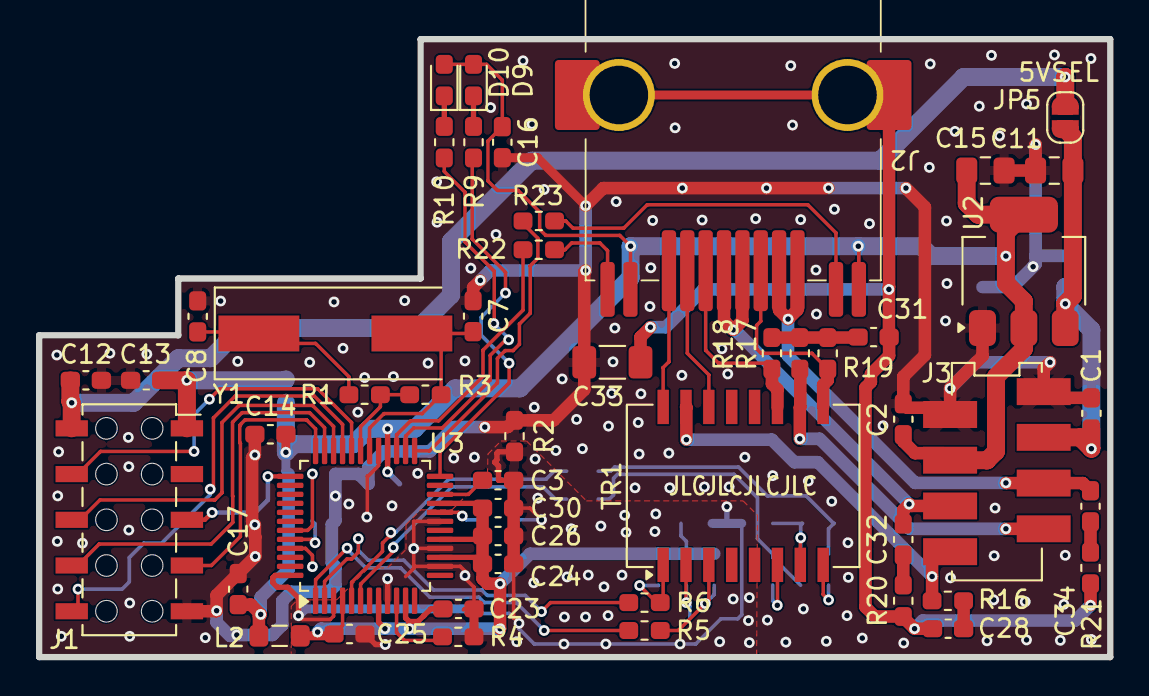
[picture p79: board ETH_W5500.kicad_pcb from above]

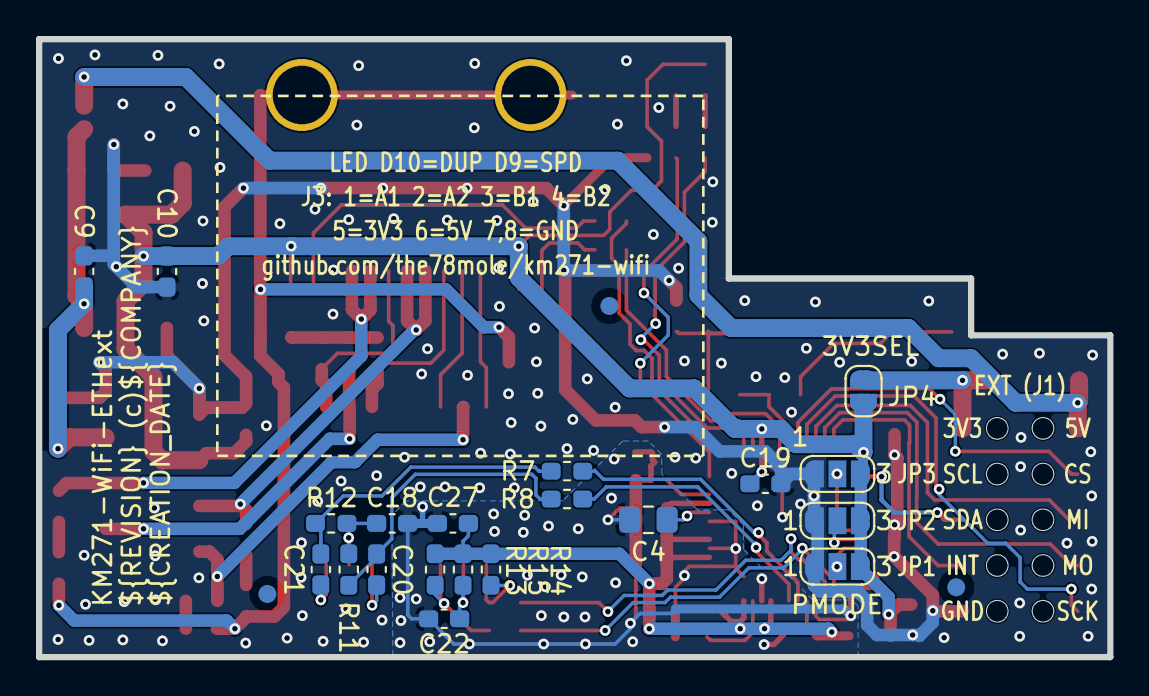
[picture p80: board ETH_W5500.kicad_pcb from below]

Board: 2 copper layers, 59.5 x 34.3 mm, 72 parts (23 on the bottom side), 55 nets.

Other parts of the board:
FID1, FID2, FID3: Fiducial_1mm_Mask2mm
