MaxRink/km271-wifi/KM217-WiFi/KM217-WiFi.kicad_pcb

## KiCad design KM217-WiFi/KM217-WiFi.kicad_pcb (2026-10-25)

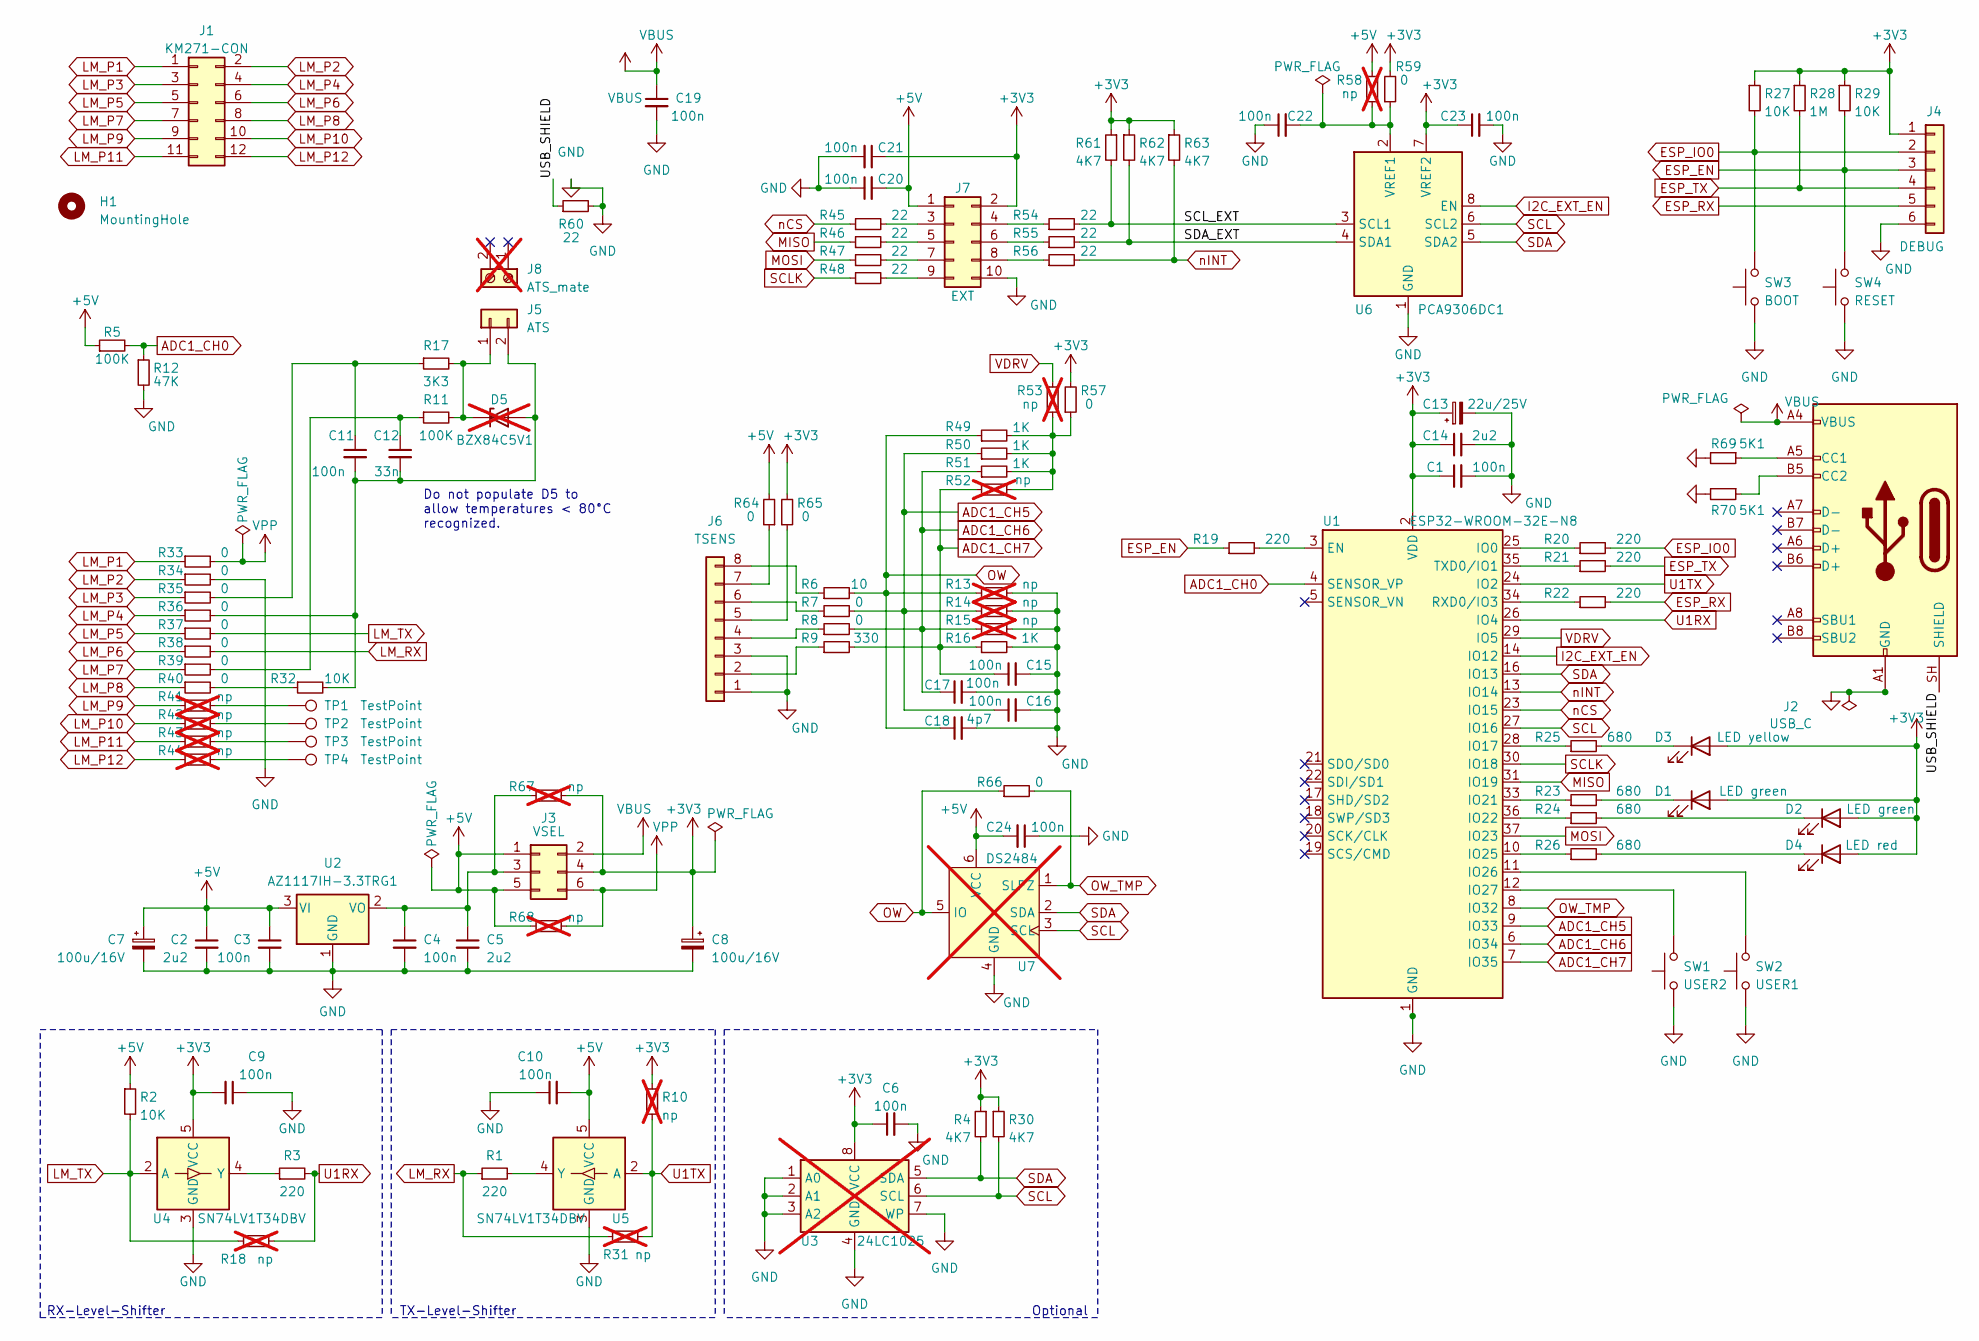
[picture p81: schematic KM217-WiFi.kicad_sch, Buderus-KM217-WIFI]

Parts:
C1, C3, C4, C6, C9, C10, C11, C15, C16, C17, C19, C20, C21, C22, C23, C24: 100n; C_0603_1608Metric_Pad1.08x0.95mm_HandSolder; MPN C0603_100n; LCSC C14663
C2, C5, C14: 2u2; C_0603_1608Metric_Pad1.08x0.95mm_HandSolder; MPN C0603_2u2; LCSC C23630
C7, C8: 100u/16V; CP_Elec_6.3x5.4_Nichicon; MPN UWT1C101MCL1GB; LCSC C340722
C12: 33n; C_0603_1608Metric_Pad1.08x0.95mm_HandSolder; MPN C0603_33n; LCSC C21117
C13: 22u/25V; C_1812_4532Metric_Pad1.57x3.40mm_HandSolder; MPN C4532X7R1E226MT000N; LCSC C76690
C18: 4p7; C_0603_1608Metric_Pad1.08x0.95mm_HandSolder; MPN C0603_4p7; LCSC C1669
D1, D2: LED green; LED_0603_1608Metric_Pad1.05x0.95mm_HandSolder; MPN D0603_LED_green; LCSC C12624
D3: LED yellow; LED_0603_1608Metric_Pad1.05x0.95mm_HandSolder; MPN D0603_LED_yellow; LCSC C2287
D4: LED red; LED_0603_1608Metric_Pad1.05x0.95mm_HandSolder; MPN D0603_LED_red; LCSC C2286
D5: BZX84C5V1; D_SOT-23_ANK; MPN BZX84C5V1-7-F; Digikey BZX84C5V1-7-F; not fitted
H1: MountingHole; MountingHole_3.2mm_M3_DIN965
J1: KM271-CON; LM2107_ComModuleCon; MPN PCB gold fingers
J2: USB_C; USB_C_Receptacle_HRO_TYPE-C-31-M-12; MPN TYPE-C-31-M-12; LCSC C165948
J3: VSEL; PinHeader_2x03_P2.54mm_Vertical_SMD; MPN HX PZ2.54-2x3P TP; LCSC C32713283
J4: DEBUG; PinHeader_2x03_P2.54mm_Horizontal; MPN HX PZ2.54-2x3P WC-A; LCSC C41417351
J5: ATS; PhoenixContact_MSTBA_2,5_2-G-5,08_1x02_P5.08mm_Horizontal; MPN 1757242; LCSC C90074
J6: TSENS; WAGO 2086-1208; MPN 2086-1208; LCSC C6074290
J7: EXT; PinHeader_2x05_P2.54mm_Vertical_SMD; MPN 54202-G0805LF; LCSC C3330868
J8: ATS_mate; MPN CTB9202/2; not fitted
R1, R3, R19, R20, R21, R22: 220; R_0603_1608Metric_Pad0.98x0.95mm_HandSolder; MPN R0603_220; LCSC C22962
R2, R27, R29, R32: 10K; R_0603_1608Metric_Pad0.98x0.95mm_HandSolder; MPN R0603_10K; LCSC C25804
R4, R30, R61, R62, R63: 4K7; R_0603_1608Metric_Pad0.98x0.95mm_HandSolder; MPN R0603_4K7; LCSC C23162
R5, R11: 100K; R_0603_1608Metric_Pad0.98x0.95mm_HandSolder; MPN R0603_100K; LCSC C25803
R6: 10; R_0603_1608Metric_Pad0.98x0.95mm_HandSolder; MPN R0603_10; LCSC C22859
R7, R8, R33, R34, R35, R36, R37, R38, R39, R40, R57, R59, R64, R65, R66: 0; R_0603_1608Metric_Pad0.98x0.95mm_HandSolder; MPN R0603_0; LCSC C21189
R9: 330; R_0603_1608Metric_Pad0.98x0.95mm_HandSolder; MPN R0603_330; LCSC C23138
R10, R13, R14, R15, R18, R31, R41, R42, R43, R44, R52, R53, R58, R67, R68: np; R_0603_1608Metric_Pad0.98x0.95mm_HandSolder; MPN np; not fitted
R12: 47K; R_0603_1608Metric_Pad0.98x0.95mm_HandSolder; MPN R0603_47K; LCSC C25819
R16, R49, R50, R51: 1K; R_0603_1608Metric_Pad0.98x0.95mm_HandSolder; MPN R0603_1K; LCSC C21190
R17: 3K3; R_0603_1608Metric_Pad0.98x0.95mm_HandSolder; MPN R0603_3K3; LCSC C22978
R23, R24, R25, R26: 680; R_0603_1608Metric_Pad0.98x0.95mm_HandSolder; MPN R0603_680; LCSC C23228
R28: 1M; R_0603_1608Metric_Pad0.98x0.95mm_HandSolder; MPN R0603_1M; LCSC C22935
R45, R46, R47, R48, R54, R55, R56, R60: 22; R_0603_1608Metric_Pad0.98x0.95mm_HandSolder; MPN R0603_22; LCSC C23345
R69, R70: 5K1; R_0603_1608Metric_Pad0.98x0.95mm_HandSolder; LCSC C23186
SW1: USER2; SW_SPST_B3SL-1002P; MPN B3SL-1002P; LCSC C306880
SW2: USER1; SW_SPST_B3SL-1002P; MPN B3SL-1002P; LCSC C306880
SW3: BOOT; SW_SPST_B3SL-1002P; MPN B3SL-1002P; LCSC C306880
SW4: RESET; SW_SPST_B3SL-1002P; MPN B3SL-1002P; LCSC C306880
TP1, TP2, TP3, TP4: TestPoint; TestPoint_Pad_D2.0mm
U1: ESP32-WROOM-32E-N8; ESP32-WROOM-32; MPN ESP32-WROOM-32E-N8; LCSC C701342
U2: AZ1117IH-3.3TRG1; SOT-223-3_TabPin2; MPN AZ1117IH-3.3TRG1; LCSC C108495
U3: 24LC1025; SO-8_5.3x6.2mm_P1.27mm; MPN 24LC1025-I/SM; not fitted
U4, U5: SN74LV1T34DBV; SOT-23-5; MPN SN74LV1T34DBVR; LCSC C100024
U6: PCA9306DC1; VSSOP-8_2.3x2mm_P0.5mm; MPN PCA9306DC1Z; LCSC C5119911
U7: DS2484; SOT-23-6_Handsoldering; MPN DS2484R+T; Digikey DS2484R+T; not fitted

Connections:
+3V3: C1.1, C6.1, C8.1, C9.2, C13.1, C14.1, C21.1, C23.1, D1.2 (A), D2.2 (A), D3.2 (A), D4.2 (A), J3.4, J4.1, J7.2, R4.1, R10.1, R27.1, R28.1, R29.1, R30.1, R57.2, R59.2, R61.1, R62.1, R63.1, R65.2, R67.2, U1.2 (VDD), U3.8 (VCC), U4.5 (VCC), U6.7 (VREF2)
+5V: C2.1, C3.1, C7.1, C10.2, C20.2, C24.2, J3.1, J3.5, J7.1, R2.1, R5.1, R58.2, R64.2, R68.1, U2.3 (VI), U5.5 (VCC), U7.6 (VCC)
/SCL_EXT: R54.2, R61.2, U6.3 (SCL1)
/SDA_EXT: R55.2, R62.2, U6.4 (SDA1)
/USB_SHIELD: J2.SH (SHIELD), R60.1
ADC1_CH0: R5.2, R12.1, U1.4 (SENSOR_VP)
ADC1_CH5: C16.1, R7.2, R14.1, R50.1, U1.9 (IO33)
ADC1_CH6: C17.1, R8.2, R15.1, R51.1, U1.6 (IO34)
ADC1_CH7: C15.1, R9.2, R16.1, R52.1, U1.7 (IO35)
ESP_EN: J4.3, R19.1, R29.2, SW4.2
ESP_IO0: J4.2, R20.2, R27.2, SW3.2
ESP_RX: J4.5, R22.2
ESP_TX: J4.4, R21.2, R28.2
GND: C1.2, C2.2, C3.2, C4.2, C5.2, C6.2, C7.2, C8.2, C9.1, C10.1, C13.2, C14.2, C15.2, C16.2, C17.2, C18.2, C19.2, C20.1, C21.2, C22.1, C23.2, C24.1, J2.A1 (GND), J2.A12 (GND), J2.B1 (GND), J2.B12 (GND), J4.6, J6.1, J6.3, J7.10, R12.2, R13.2, R14.2, R15.2, R16.2, R34.2, R60.2, R69.2, R70.2, SW1.1, SW2.1, SW3.1, SW4.1, U1.1 (GND), U1.15 (GND), U1.38 (GND), U1.39 (GND), U2.1 (GND), U3.1 (A0), U3.2 (A1), U3.3 (A2), U3.4 (GND), U3.7 (WP), U4.3 (GND), U5.3 (GND), U6.1 (GND), U7.4 (GND)
I2C_EXT_EN: U1.14 (IO12), U6.8 (EN)
LM_P1: J1.1, R33.1
LM_P2: J1.2, R34.1
LM_P3: J1.3, R35.1
LM_P4: J1.4, R36.1
LM_P5: J1.5, R37.1
LM_P6: J1.6, R38.1
LM_P7: J1.7, R39.1
LM_P8: J1.8, R40.1
LM_P9: J1.9, R41.1
LM_P10: J1.10, R42.1
LM_P11: J1.11, R43.1
LM_P12: J1.12, R44.1
LM_RX: R1.1, R31.1, R38.2
LM_TX: R2.2, R18.1, R37.2, U4.2 (A)
MISO: R46.1, U1.31 (IO19)
MOSI: R47.1, U1.37 (IO23)
unnamed: C11.1, R17.1, R35.2
unnamed: C12.1, R11.1, R39.2
unnamed: D1.1 (K), R23.2
unnamed: D2.1 (K), R24.2
unnamed: D3.1 (K), R25.2
unnamed: D4.1 (K), R26.2
unnamed: C11.2, C12.2, D5.2 (A), J5.2, R32.2, R36.2
unnamed: D5.1 (K), J5.1, R11.2, R17.2
unnamed: J2.A5 (CC1), R69.1
unnamed: J2.B5 (CC2), R70.1
unnamed: C4.1, C5.1, J3.3, R67.1, U2.2 (VO)
unnamed: J6.2, R9.1
unnamed: J6.4, R8.1
unnamed: J6.5, R65.1
unnamed: J6.6, R7.1
unnamed: J6.7, R64.1
unnamed: J6.8, R6.1
unnamed: J7.3, R45.2
unnamed: J7.4, R54.1
unnamed: J7.5, R46.2
unnamed: J7.6, R55.1
unnamed: J7.7, R47.2
unnamed: J7.8, R56.1
unnamed: J7.9, R48.2
unnamed: R32.1, R40.2
unnamed: R41.2, TP1.1
unnamed: R42.2, TP2.1
unnamed: R43.2, TP3.1
unnamed: R44.2, TP4.1
unnamed: R49.2, R50.2, R51.2, R52.2, R53.1, R57.1
unnamed: R19.2, U1.3 (EN)
unnamed: R20.1, U1.25 (IO0)
unnamed: R25.1, U1.28 (IO17)
unnamed: R23.1, U1.33 (IO21)
unnamed: R24.1, U1.36 (IO22)
unnamed: R26.1, U1.10 (IO25)
unnamed: SW2.2, U1.11 (IO26)
unnamed: SW1.2, U1.12 (IO27)
unnamed: R22.1, U1.34 (RXD0/IO3)
unnamed: R21.1, U1.35 (TXD0/IO1)
unnamed: R3.1, U4.4 (Y)
unnamed: R1.2, U5.4 (Y)
unnamed: C22.2, R58.1, R59.1, U6.2 (VREF1)
OW: C18.1, R6.2, R13.1, R49.1, R66.1, U7.5 (IO)
OW_TMP: R66.2, U1.8 (IO32), U7.1 (SLPZ)
SCL: R30.2, U1.27 (IO16), U3.6 (SCL), U6.6 (SCL2), U7.3 (SCL)
SCLK: R48.1, U1.30 (IO18)
SDA: R4.2, U1.16 (IO13), U3.5 (SDA), U6.5 (SDA2), U7.2 (SDA)
U1RX: R3.2, R18.2, U1.26 (IO4)
U1TX: R10.2, R31.2, U1.24 (IO2), U5.2 (A)
VBUS: C19.1, J2.A4 (VBUS), J2.A9 (VBUS), J2.B4 (VBUS), J2.B9 (VBUS), J3.2
VDRV: R53.2, U1.29 (IO5)
VPP: J3.6, R33.2, R68.2
nCS: R45.1, U1.23 (IO15)
nINT: R56.2, R63.2, U1.13 (IO14)

Notes on the sheet:
RX-Level-Shifter
TX-Level-Shifter
Optional
Do not populate D5 to allow temperatures < 80°C recognized.

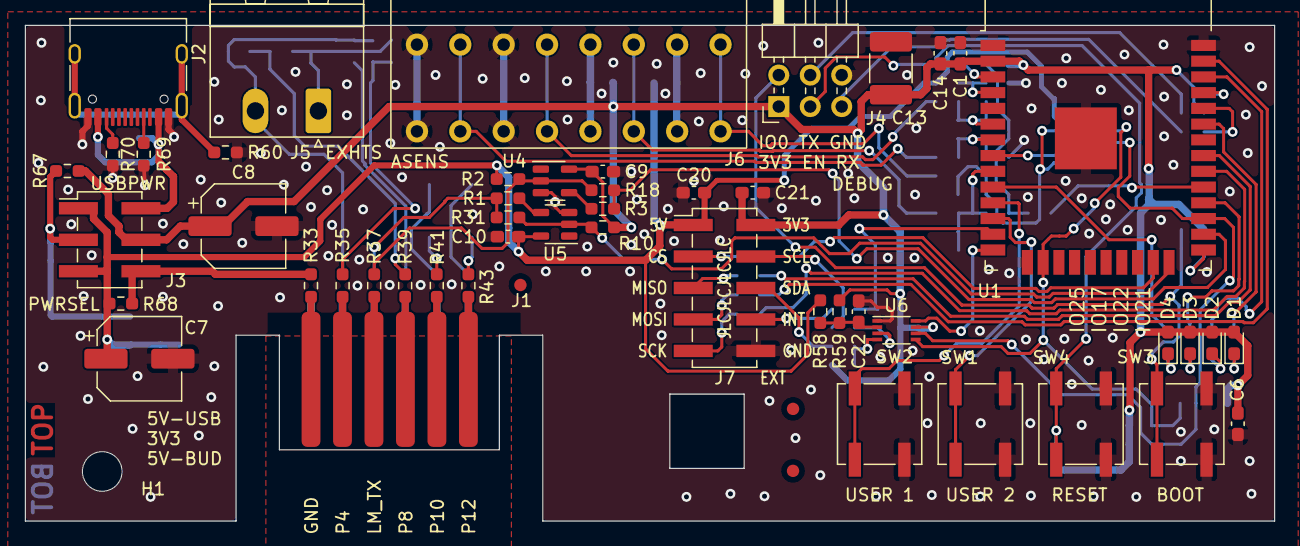
[picture p82: board KM217-WiFi.kicad_pcb from above]

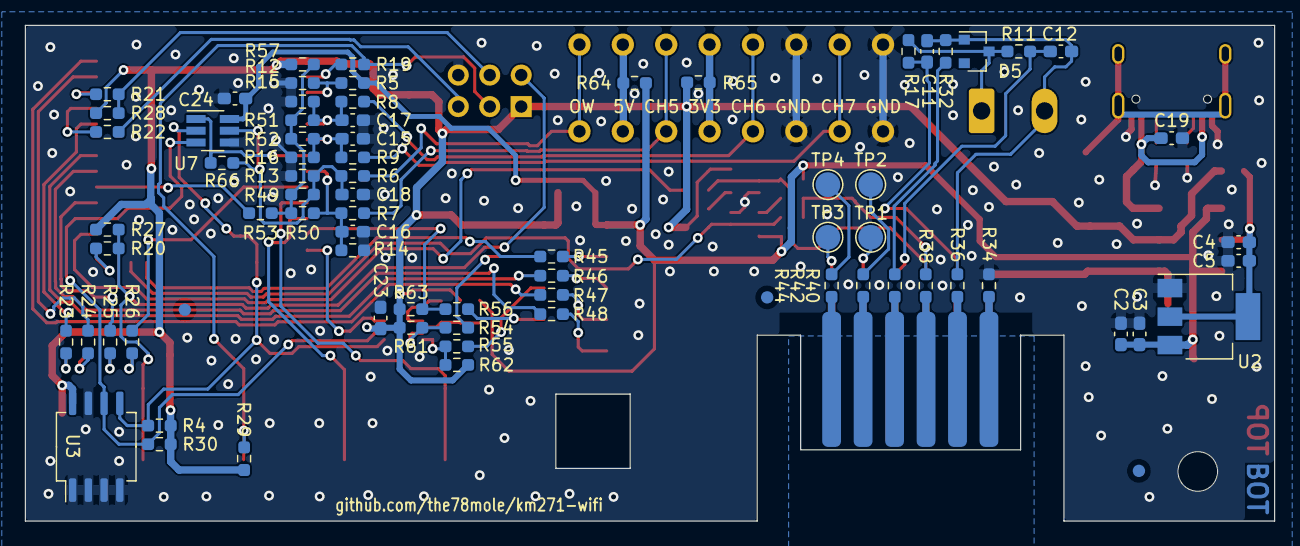
[picture p83: board KM217-WiFi.kicad_pcb from below]

Board: 2 copper layers, 100.8 x 40.0 mm, 128 parts (75 on the bottom side), 86 nets.

Other parts of the board:
FID1, FID2, FID3, FID4, FID5, FID6: Fiducial_1mm_Mask2mm
