MaxRink/km271-wifi/(commit log)

2026-10-25 feat(main): add LCSC part numbers and JLC part swaps to schematic
    U1 ESP32-WROOM-32E-N8 (C701342), U4/U5 SN74LV1T34DBVR (C100024),
    C13 22u 1206 (C12891), J3 HX 2x3 SMD header (C32713283), JLC basic
    passives/LEDs. Adds scripts/jlc/sch_lcsc.py to apply the mapping.
    [KM217-WiFi.kicad_sch]
2026-10-25 feat(eth): add LCSC part numbers, AMS1117, 3225 crystal; fix ERC
    ETH: LCSC fields for all fitted parts, U2 AMS1117-3.3 (C6186),
    Y1 3225 25MHz (C9006) with GND24 crystal symbol, J1 SMD 2x5 socket
    C843271, PWR_FLAGs. Main: no-connect J8 pins. Both schematics: 0 ERC errors.
    [ETH_W5500.kicad_sch, KM217-WiFi.kicad_sch]
2026-10-25 feat: minimal-change JLC BOM fields on schematics and PCBs
    Keep original footprints/layout. Main: C13 TDK 1812 (C76690), U1
    32E-N8 on the existing WROOM-32 land pattern. ETH: U2 AZ1117IH-3.3
    (ceramic-stable, AMS1117 needs tantalum), Y1 Abracon ABLS2 18pF
    HC-49SMD (C596824). Sync Value/LCSC/MPN/DNP into PCBs, refill zones
    (KiCad 10 format). DRC 0 errors, ERC 0 errors on both boards.
    [ETH_W5500.kicad_pcb, ETH_W5500.kicad_sch, KM217-WiFi.kicad_pcb, KM217-WiFi.kicad_sch]
2026-10-25 feat: enforce JLCPCB design rules in DRC; gold finger edge clearance
    Add jlcpcb.kicad_dru (from jlcpcb.com capabilities, 2026-10) and
    board-setup minima to both projects. Shorten J1 finger pads 0.1 mm
    for 0.2 mm copper-to-edge, restore original BOM/pos exclude flags,
    sync all symbol fields to footprints, solid GNDA connection on C25.
    DRC: 0 errors on both boards with JLC rules.
    [ETH_W5500.kicad_pcb, KM217-WiFi.kicad_pcb]
2026-10-25 feat: silkscreen labels, fiducials, gold finger fab note, v1.1.0
    Main: EXT (J7) pinout labels, repo URL, hidden JLC order-number
    placeholder under J7, J1 fab note (gold fingers yes, bevel not
    possible), GOLD_FINGERS rule area, 3+3 fiducials. ETH: 3 bottom
    fiducials (no room on top without moving parts). Revision v1.1.0.
    DRC 0 errors on both boards.
    [ETH_W5500.kicad_pcb, KM217-WiFi.kicad_pcb]
2026-10-25 feat(eth): silkscreen pinouts, LED legend, repo URL, JLC placeholder
    EXT (J1) pin labels and J3 legend on bottom silk, LED function legend
    (D10 duplex, D9 speed), repo URL, hidden JLC order-number placeholder
    under TR1. DRC 0 errors.
    [ETH_W5500.kicad_pcb]
2026-10-25 fix: correct JLC BOM/CPL (U6 missing, rotations, non-parts)
    - Remove stray empty 'dnp' footprint fields: Fabrication Toolkit treated
    U6 (PCA9306) and others as DNP and dropped them from BOM/CPL.
    - Exclude J1 fingers, H1, TPs, solder jumpers, fiducials from BOM/CPL.
    - CPL rotation/offset overrides verified against JLC's EasyEDA footprints
    (scripts/jlc/check_cpl_rotation.py): U1 270deg + 0.745 mm origin offset,
    J3/J7/ETH-J1 270, ETH-TR1 0, SW3/4 270 (DB +90 would rotate the B3SL
    off its pads), C7/C8 0 (DB 180 would reverse elco polarity).
    - Regenerate production files with Fabrication Toolkit.
    [ETH_W5500.kicad_pcb, ETH_W5500.kicad_sch, KM217-WiFi.kicad_pcb, KM217-WiFi.kicad_sch, bom.csv, designators.csv, positions.csv]
2026-10-25 docs: JLCPCB production files, ordering guide and README section
    Fab zips, BOM/CPL, iBOM, schematic/PCB PDFs, STEP and renders for both
    boards (scripts/jlc/make_outputs.sh). DOC/JLCPCB-ordering.md: order
    options, datasheet-checked part swaps, JLC compliance checklist, CPL
    rotation verification, cost estimate. Before renders in IMG/jlc.
    [ETH_W5500.step, KM217-WiFi.kicad_pcb, KM217-WiFi.step]
2026-10-25 feat(main): USB-C power input, 3D models for all parts, DRC/ERC warning cleanup
    - J2 Mini-B -> HRO TYPE-C-31-M-12 (C165948), power only (D+/D- were
    unused): CC1/CC2 each 5k1 to GND (R69/R70, C23186), shield via R60
    as before. Local re-route around J2 only (scripts/jlc/usbc_swap.py),
    GND vias removed from under the metal shell. CPL offset verified
    against JLC footprint.
    - 3D models in 3dmodels/ (project-relative): USB-C and TR1 from
    EasyEDA, stock B3SL/SOIC-8 for SW1-4/U3, approximate boxes for
    RJ45, WR-MM and WAGO (vendor models not available offline).
    - Parity cleanup: power symbols instead of local GND/VBUS labels,
    PWR_FLAGs, SW1-4 footprint field, J8 not on board, fiducials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
    [ETH_W5500.kicad_pcb, KM217-WiFi.kicad_pcb, KM217-WiFi.kicad_sch, USB-C_HRO_TYPE-C-31-M-12.step, Wuerth_749013011A.step, bom.csv, designators.csv, positions.csv]
2026-10-25 fix: LED silkscreen order, visible refdes, fab notes, pour pullback
    - Main: LED labels were reversed vs. nets (D1=IO21 ... D4=IO25); fixed.
    - All refdes visible (R10, H1, ETH JP1-3 placed instead of hidden).
    - ETH fiducials restored/placed clear of JP1 text and copper.
    - Fab notes (stackup, finish, gold finger, assembly) on Cmts.User.
    - Copper pours pulled back 0.5 mm from routed edges (zone-only rule).
    - scripts/jlc/verify.py: pin-level netlist diff vs upstream, placement
    diff, BOM/CPL/PCB refdes consistency, hidden refdes, connector nets.
    [ETH_W5500.kicad_pcb, ETH_W5500.step, KM217-WiFi.kicad_pcb, KM217-WiFi.step]
2026-10-25 fix(main): no GND pour/vias under USB-C shell; full-severity DRC/ERC reports
    Independent review findings: shield-net shell sat over GND pour (only
    mask between them, bypassing R60) -> F.Cu rule area USB_SHELL_NO_POUR.
    DRC/ERC reports now include warnings. Docs: J8 change and ETH top
    fiducial workaround stated explicitly.
    [ETH_W5500.step, KM217-WiFi.kicad_pcb, KM217-WiFi.step]
2026-10-25 fix: replace out-of-stock green/yellow LEDs (C72043/C72038 -> KENTO C12624/C2287)
    Both Everlight LEDs are extended with 0 stock; no basic green/yellow
    0603 exists. KENTO is the same family as the basic red C2286.
    check_cpl_rotation.py: --pad1-anode for anode-first LED footprints and
    --pad-map for bridged switch pins; all LEDs and SW3/SW4 now verified.
    [ETH_W5500.kicad_pcb, ETH_W5500.kicad_sch, ETH_W5500.step, KM217-WiFi.kicad_pcb, KM217-WiFi.kicad_sch, KM217-WiFi.step, bom.csv]
2026-10-25 docs: PR report generator, PR images; tidy USB-C schematic placement
    - tools/pr_report.py generates the net/BOM/placement diff tables and
    schematic/PCB before-after-diff images and 3D renders for PR bodies;
    tools/lcsc_parts.json is the JLC stock/price snapshot it uses.
    - docs/pr-images/jlcpcb-ready: images for PR 1.
    - Main schematic: USB-C block moved off J1 into free space (mirrored),
    netlist unchanged; overlapping field texts fixed.
    [ETH_W5500.step, KM217-WiFi.kicad_sch, KM217-WiFi.step]
2026-10-25 fix(main): USB-C 3D model was rotated 180 deg (mouth into the board)
    EasyEDA places the TYPE-C-31-M-12 model with a 180 deg Z rotation in its own
    footprint; carried over. Footprint/copper unchanged (mouth at the board
    edge per HRO drawing). Renders, STEP and PR images regenerated.
    [KM217-WiFi.kicad_pcb, KM217-WiFi.step]
2026-10-25 feat(bom): populate USER buttons and DEBUG/ATS/TSENS connectors, basic ferrite on ETH
    SW1/SW2 (B3SL, same as SW3/SW4), J4 2x3 right-angle header (C41417351),
    J5 Phoenix 1757242 (C90074) and J6 WAGO 2086-1208 (C6074290, no LCSC
    stock: Global Sourcing) are now fitted. ETH L2 moves to basic C1015.
    Netlists unchanged on both boards; DRC/ERC 0 errors.
    [ETH_W5500.kicad_pcb, ETH_W5500.kicad_sch, ETH_W5500.step, KM217-WiFi.kicad_pcb, KM217-WiFi.kicad_sch, KM217-WiFi.step, bom.csv, positions.csv]
